anuic3/Poly-Silicon-Resistor-Based-Temperature-Sensor-324/lvs/CB with Chopper/Readme.txt

cb_xschem.spice is the spice file taken from xschem and cb_final_flat.spice is the lvs compatible magic extracted file.
comp.out is the output file from Netgen showing the results.
Clearly the number of devices and the number of netlist are same but it shows the netlists do not match.
