anuic3/Poly-Silicon-Resistor-Based-Temperature-Sensor-324/lvs/Counter/Readme.txt

20bitCounter_fromSchematic.spice is the spice file taken from xschem and 20bitCounter_fromLayout.spice is the lvs compatible magic extracted file.
lvsReport.out is the output file from Netgen showing the results.
Clearly the circuits and netlists match uniquely.
