anuic3/Poly-Silicon-Resistor-Based-Temperature-Sensor-324/lvs/Switched capacitor/read me

"extract1.spice" is the spice file extracted from layout
"untitled-5.spice" is the spice file taken from schematic
LVS is done and its is uniquely matching
