anuic3/Poly-Silicon-Resistor-Based-Temperature-Sensor-324/lvs/Wien Bridge/Readme.txt

Wb_xschem.spice is the spice file taken from xschem and wb_flat.spice is the lvs compatible magic extracted file.
comp.out is the output file from Netgen showing the results.
Clearly the circuits and netlist match.
