anuic3/Poly-Silicon-Resistor-Based-Temperature-Sensor-324/prelayout simulations/Wien Bridge/WIEN BRIDGE PLOTS.pptx

## WIEN BRIDGE PLOTS

## Comparison Table – Resonant Frequency (in kHz)

| -35°C | 27°C | 125°C
tt | 224.91 | 247.742 | 280.5434
ll | 276 | 304.1 | 344.35
hh | 186.21 | 206.445 | 232.27
hl | 237.137 | 261.216 | 295.8
lh | 216.77 | 238.781 | 270.4

## tt - room temp

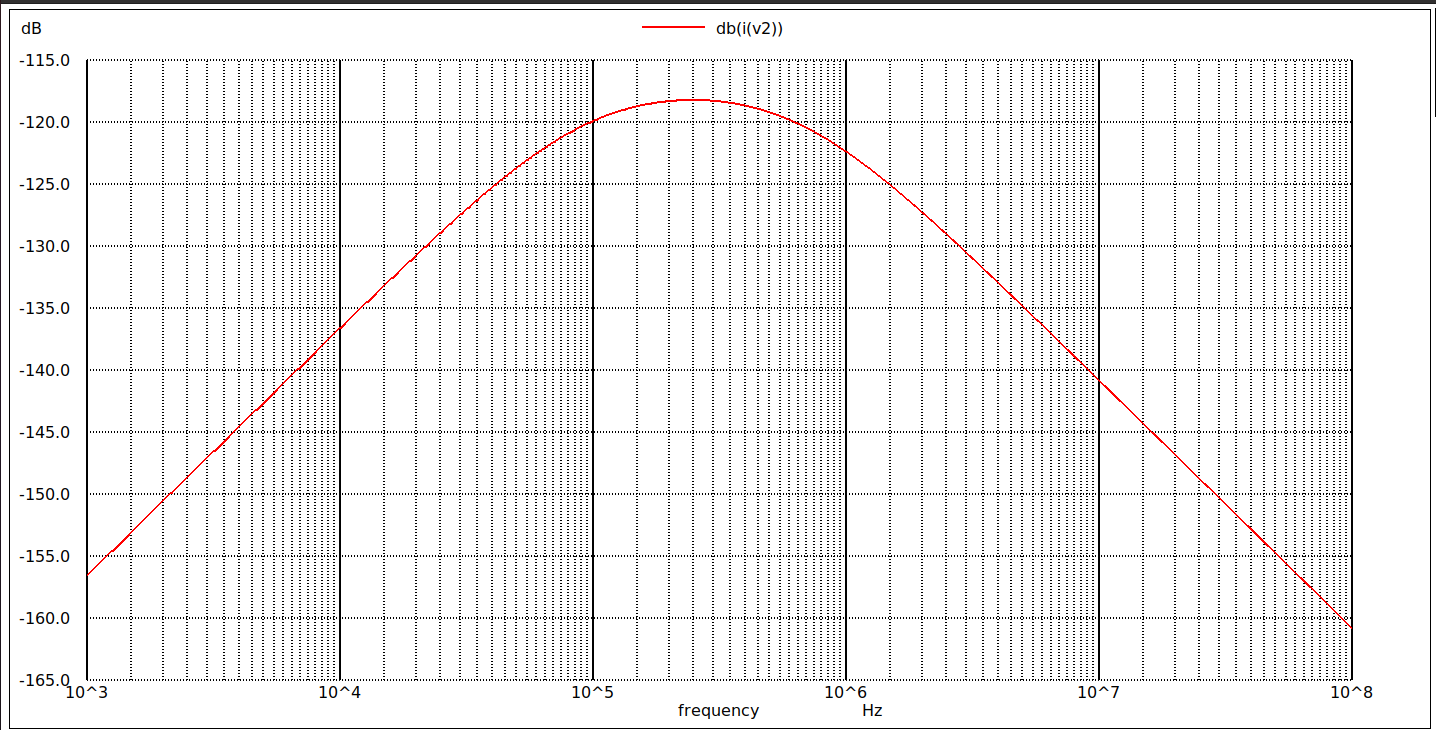
[picture p37: figure]
WBroomtt
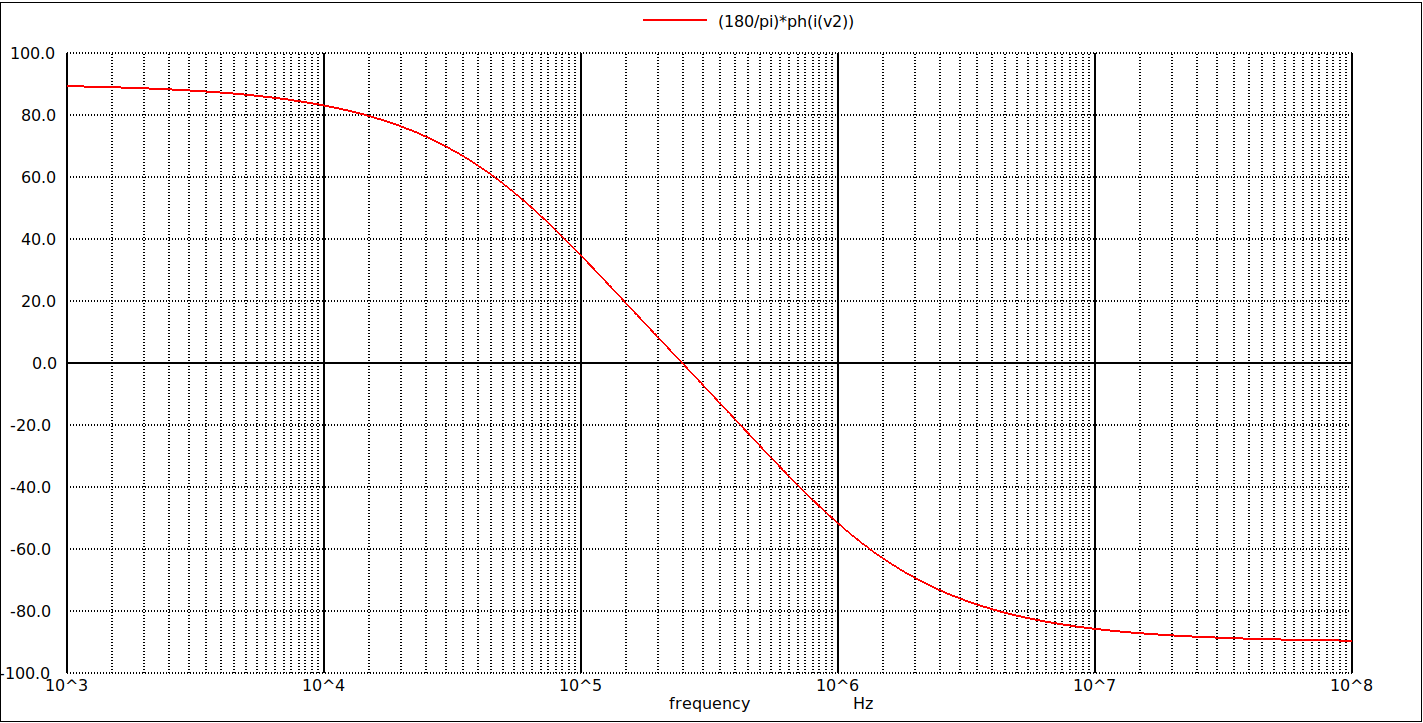
[picture p38: figure]
wbroomttph

## tt - -35degree c

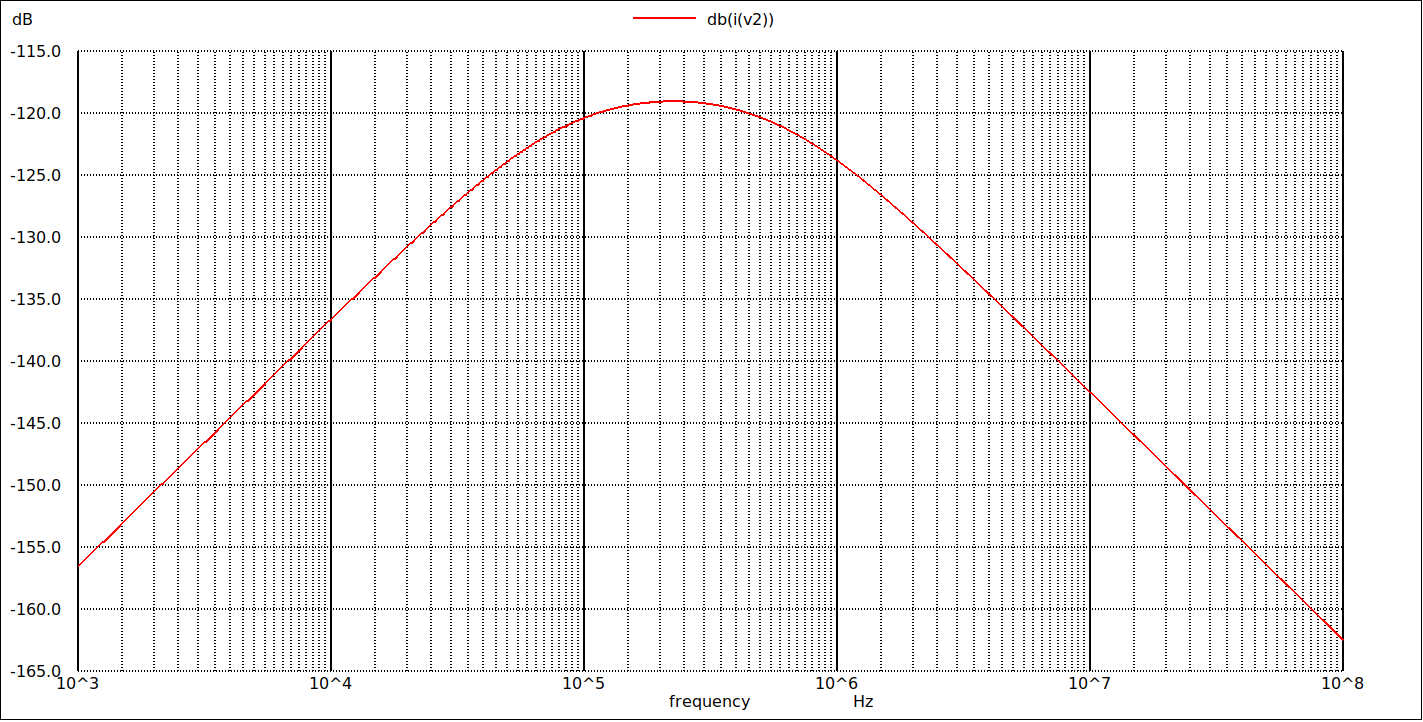
[picture p39: figure]
wb-35ttdb
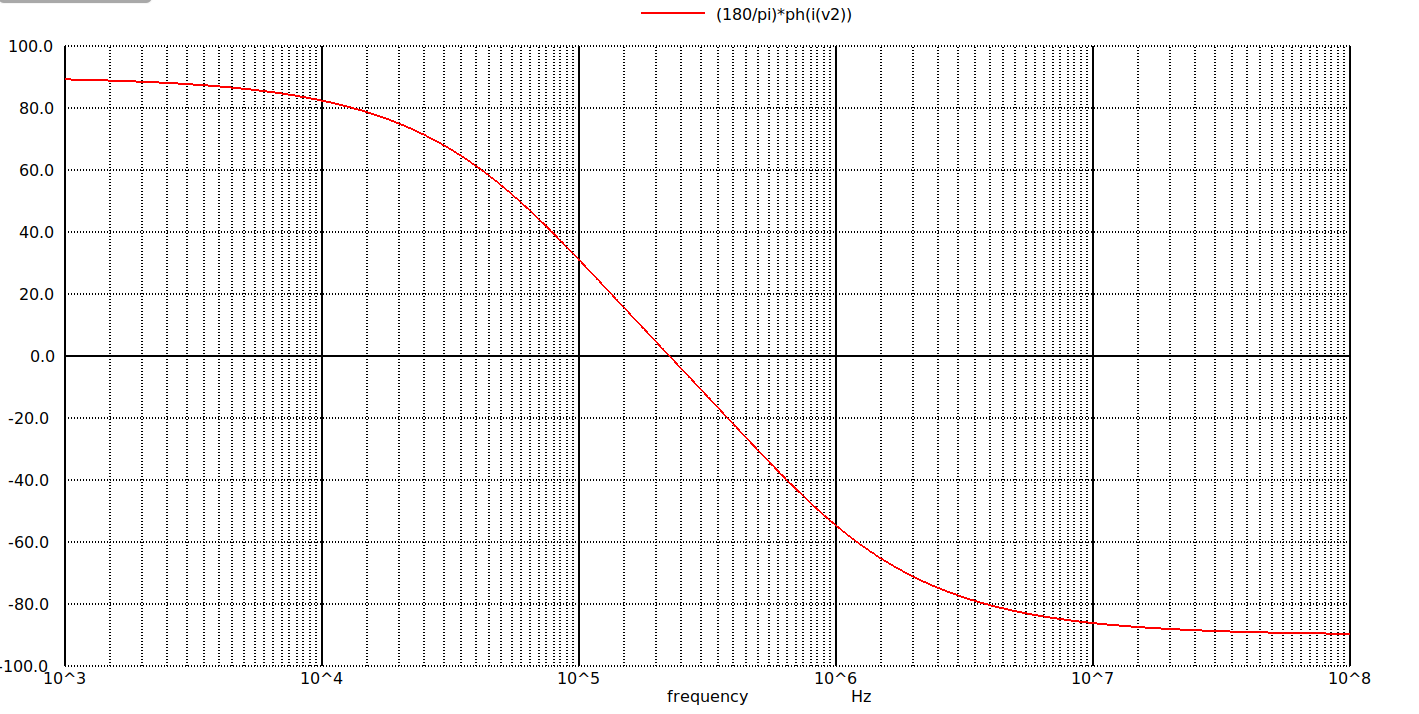
[picture p40: figure]
wb-35ttph

## tt - 125 degree c

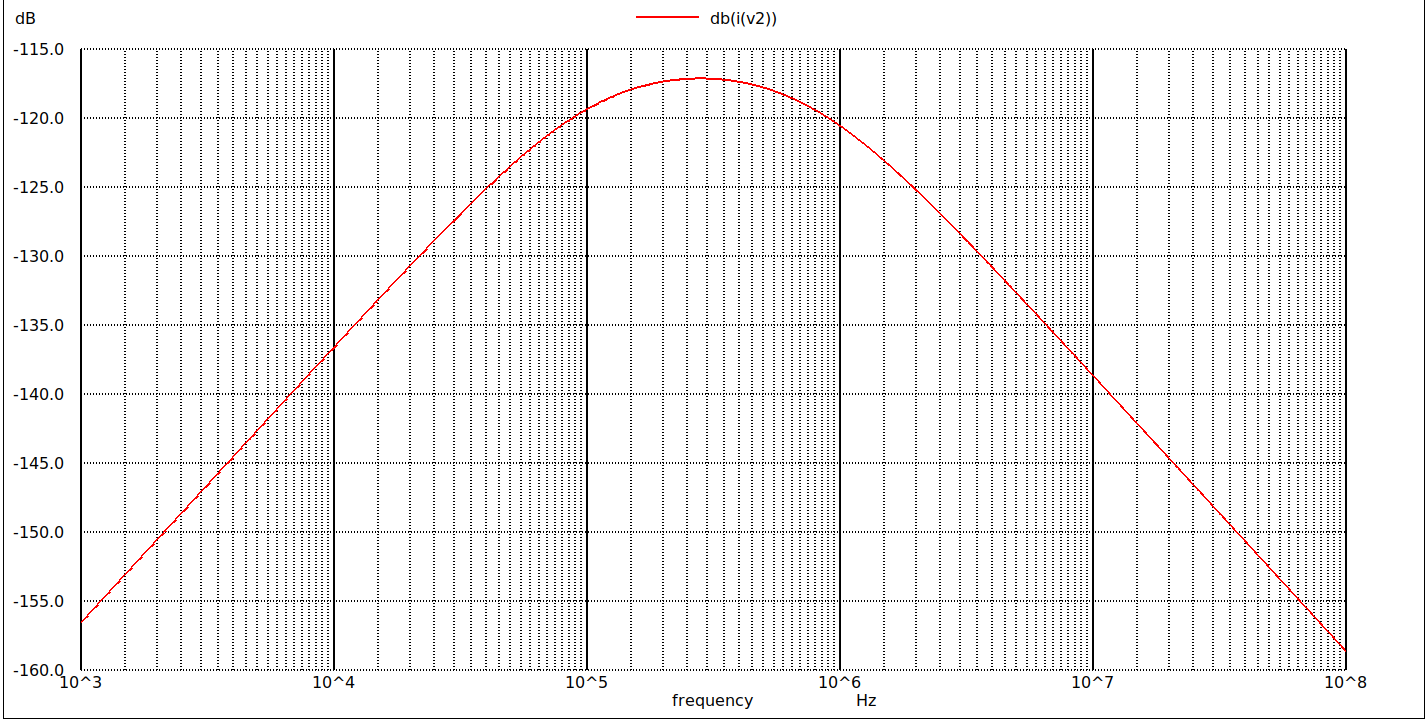
[picture p41: figure]
wb125ttdb
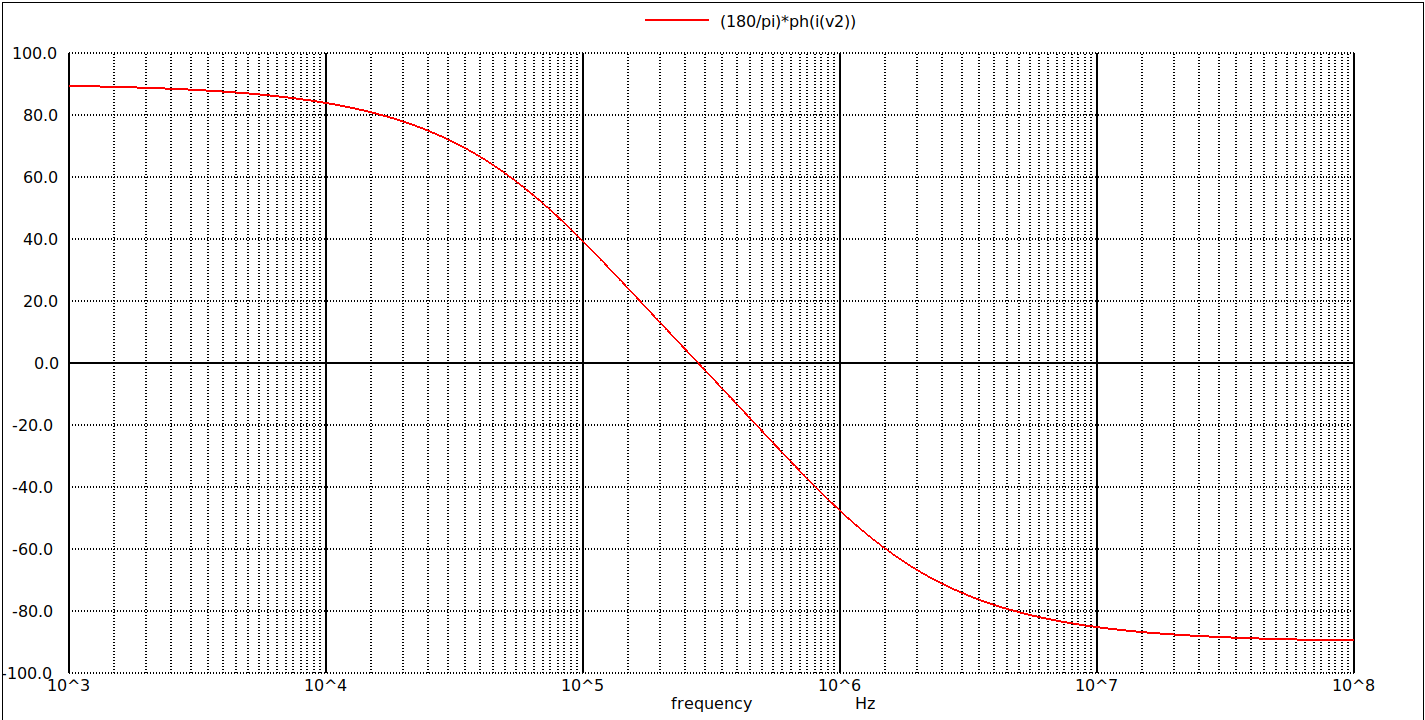
[picture p42: figure]
wb125ttph

## hh -room temp

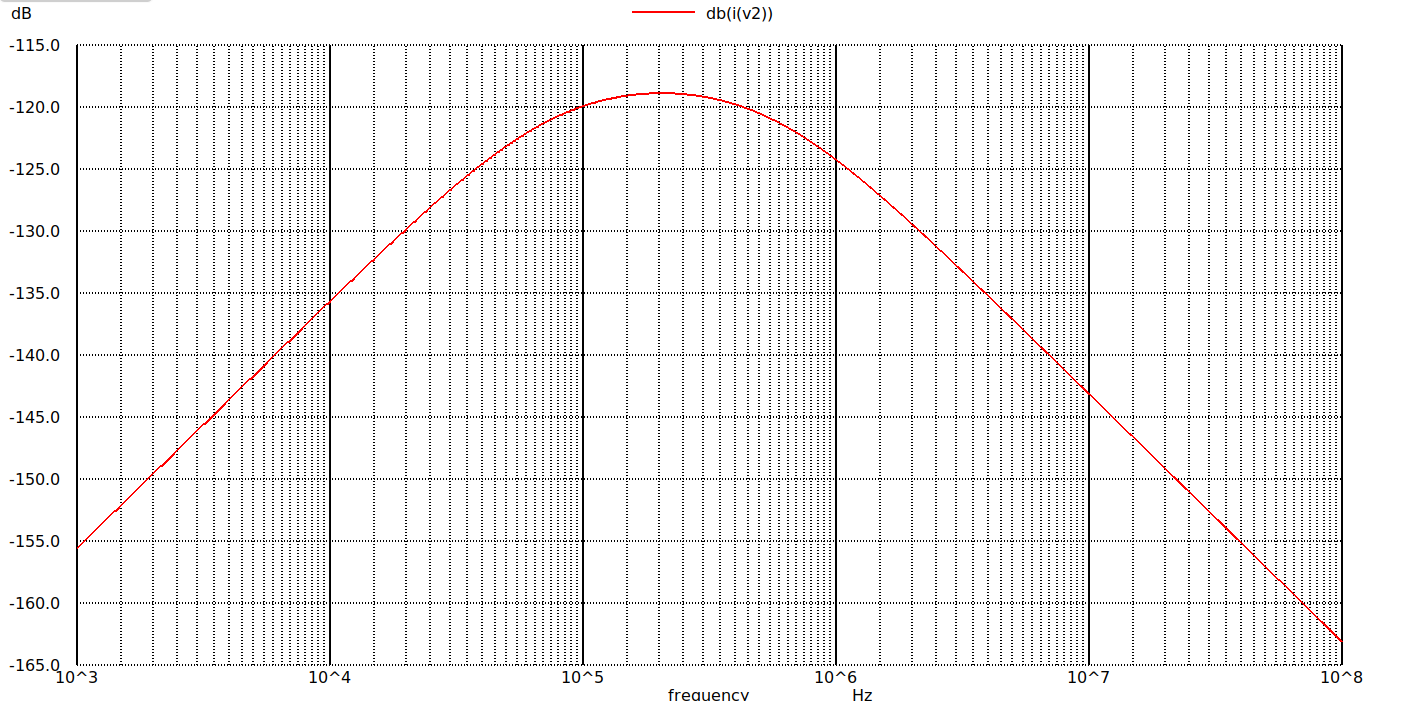
[picture p43: figure]
wbroomhhdb
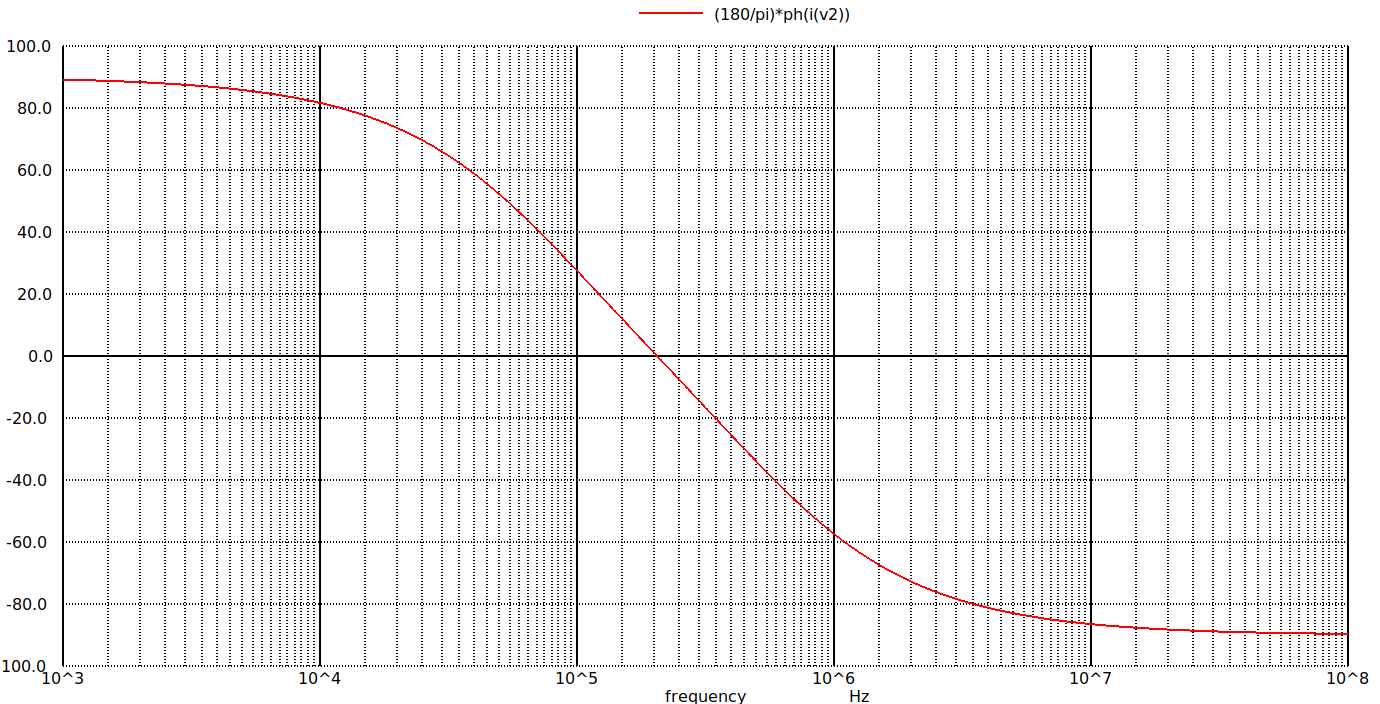
[picture p44: figure]
wbroomhhph

## hh - -35 degree c

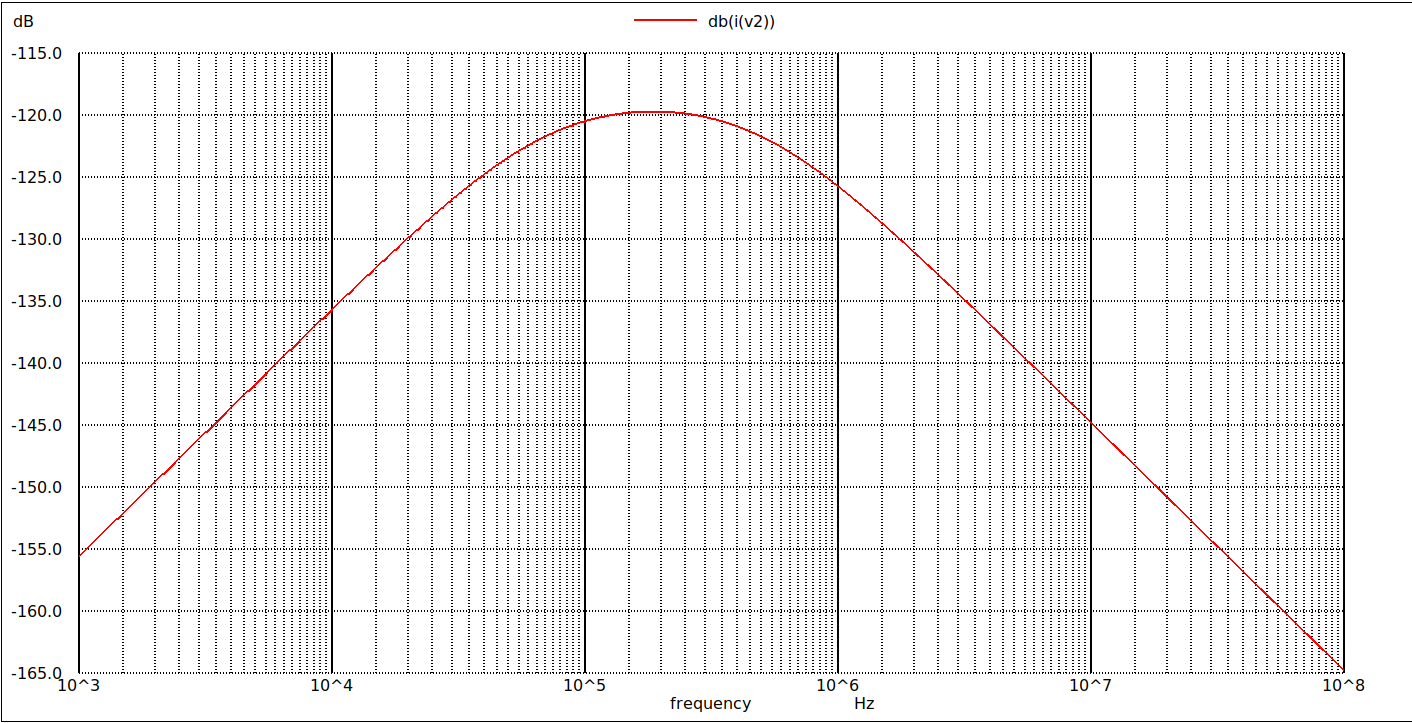
[picture p45: figure]
wb-35hhdb
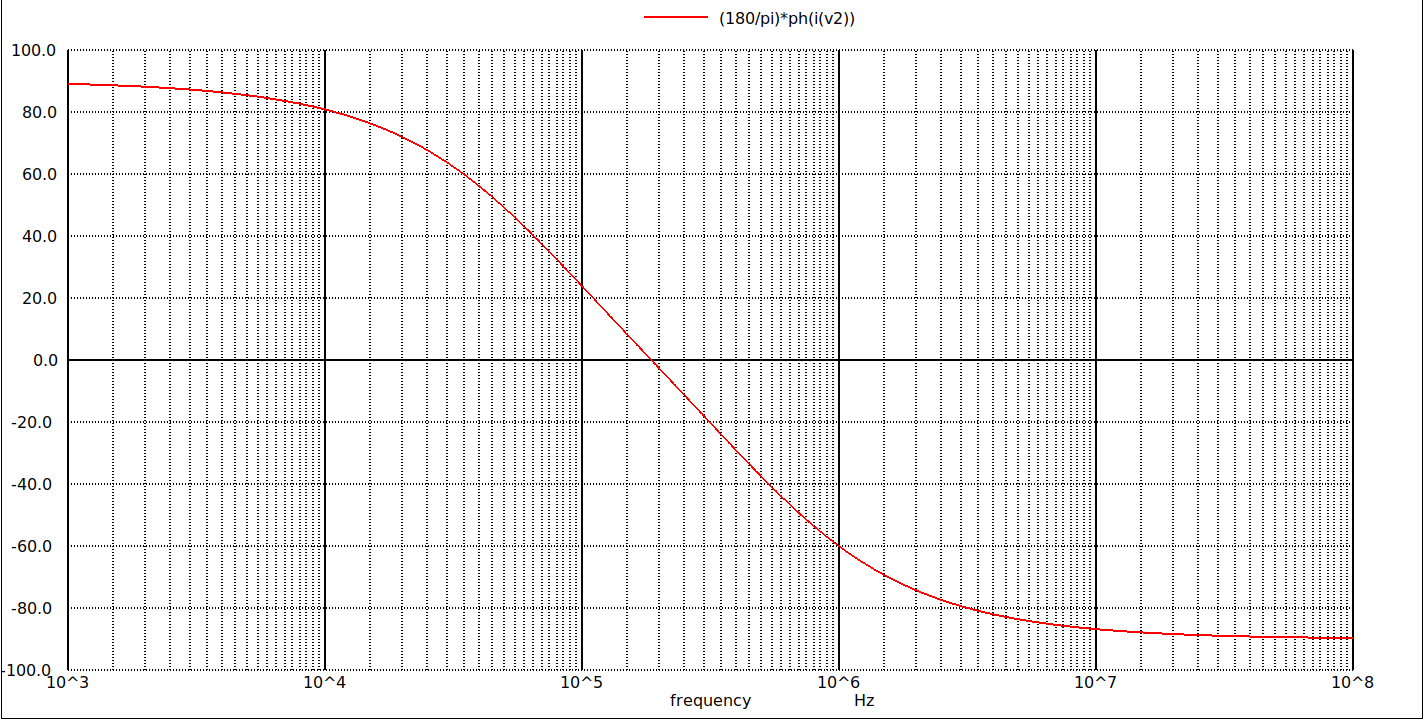
[picture p46: figure]
wb-35hhph

## hh - 125 degree c

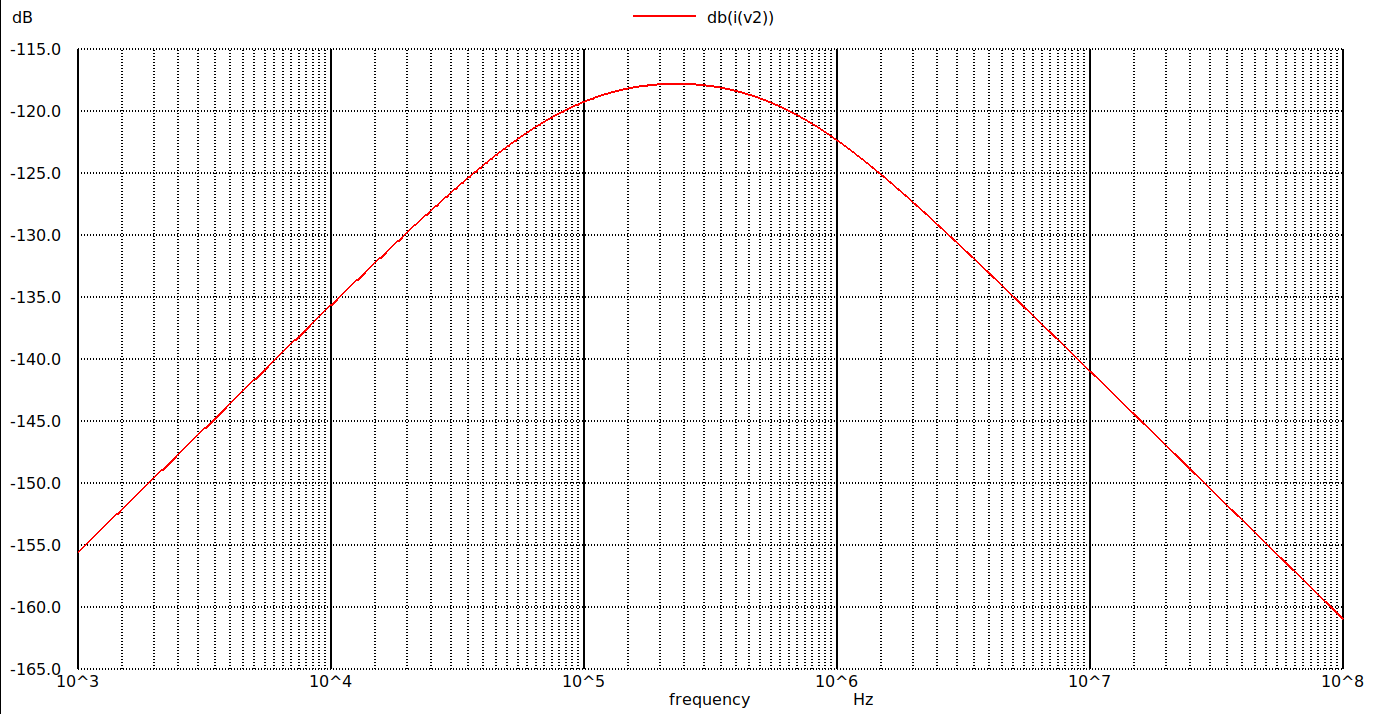
[picture p47: figure]
wb125hhdb
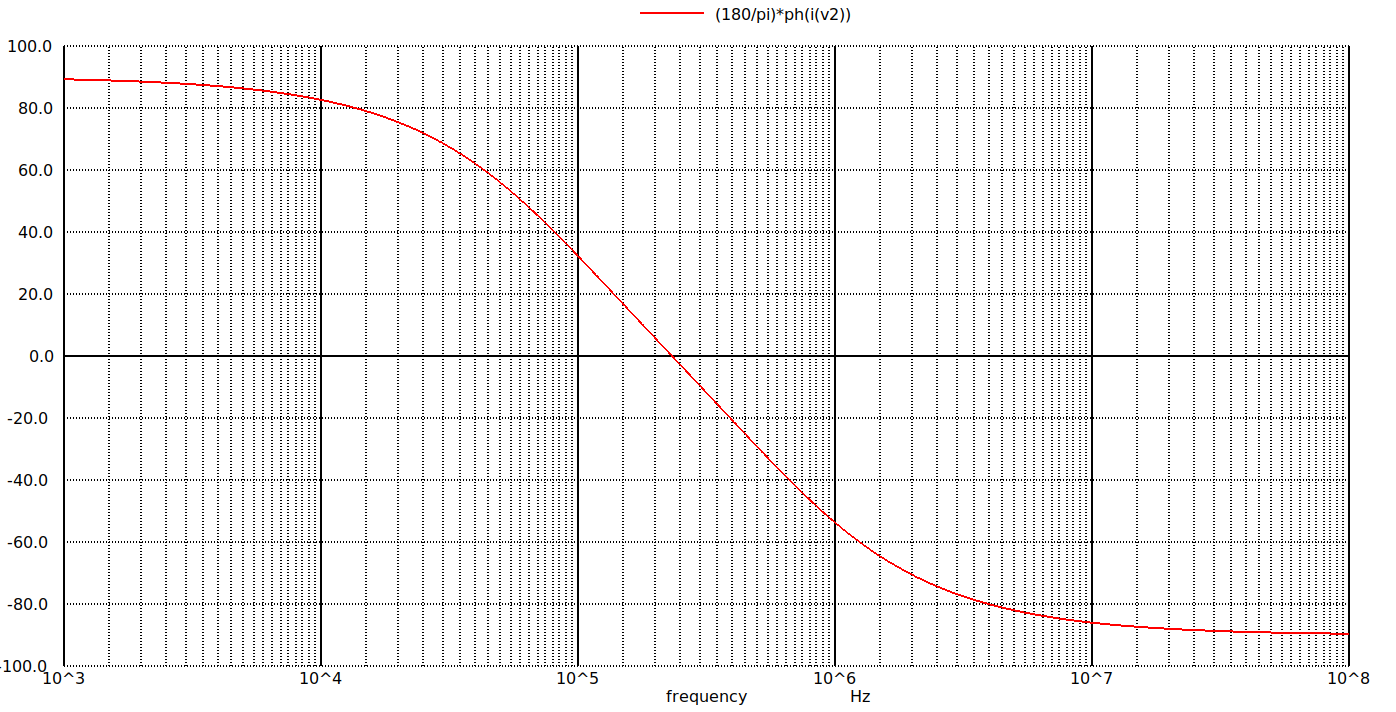
[picture p48: figure]
wb125hhph

## ll - room temp

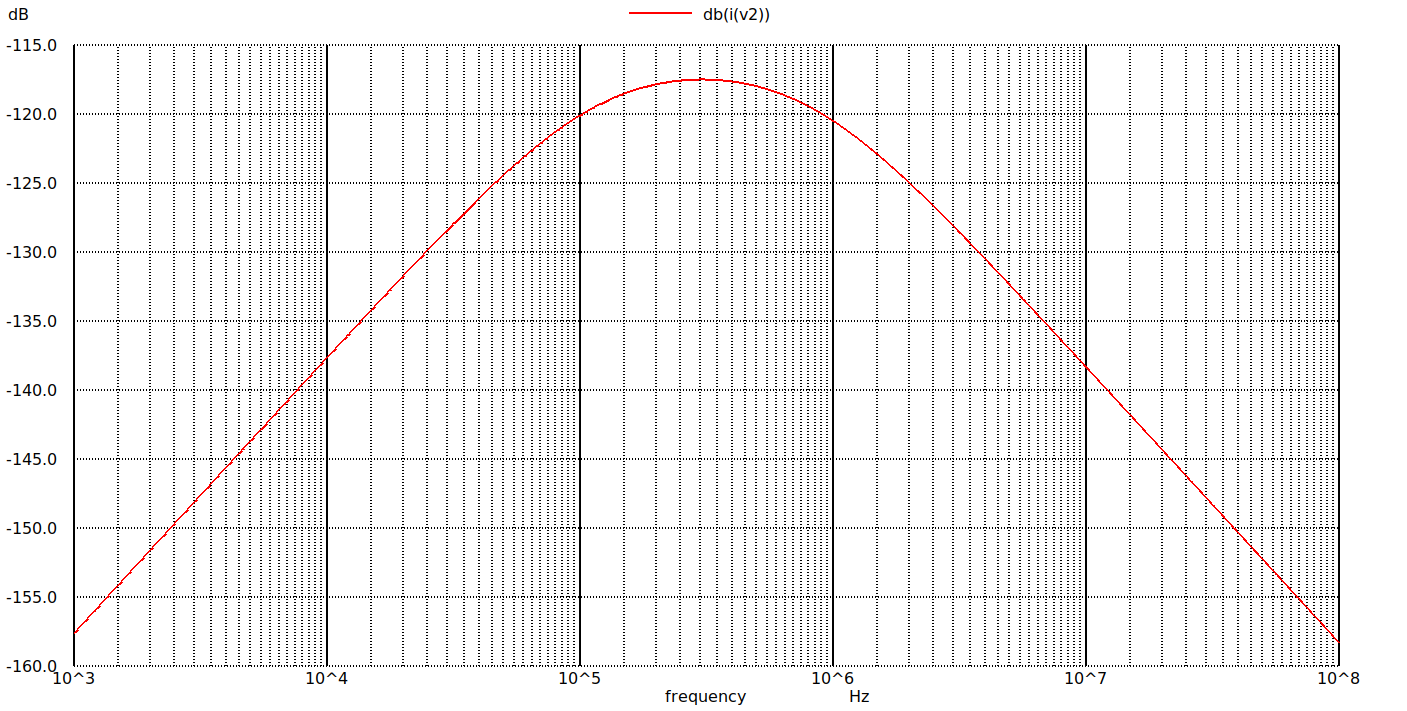
[picture p49: figure]
wbroomlldb
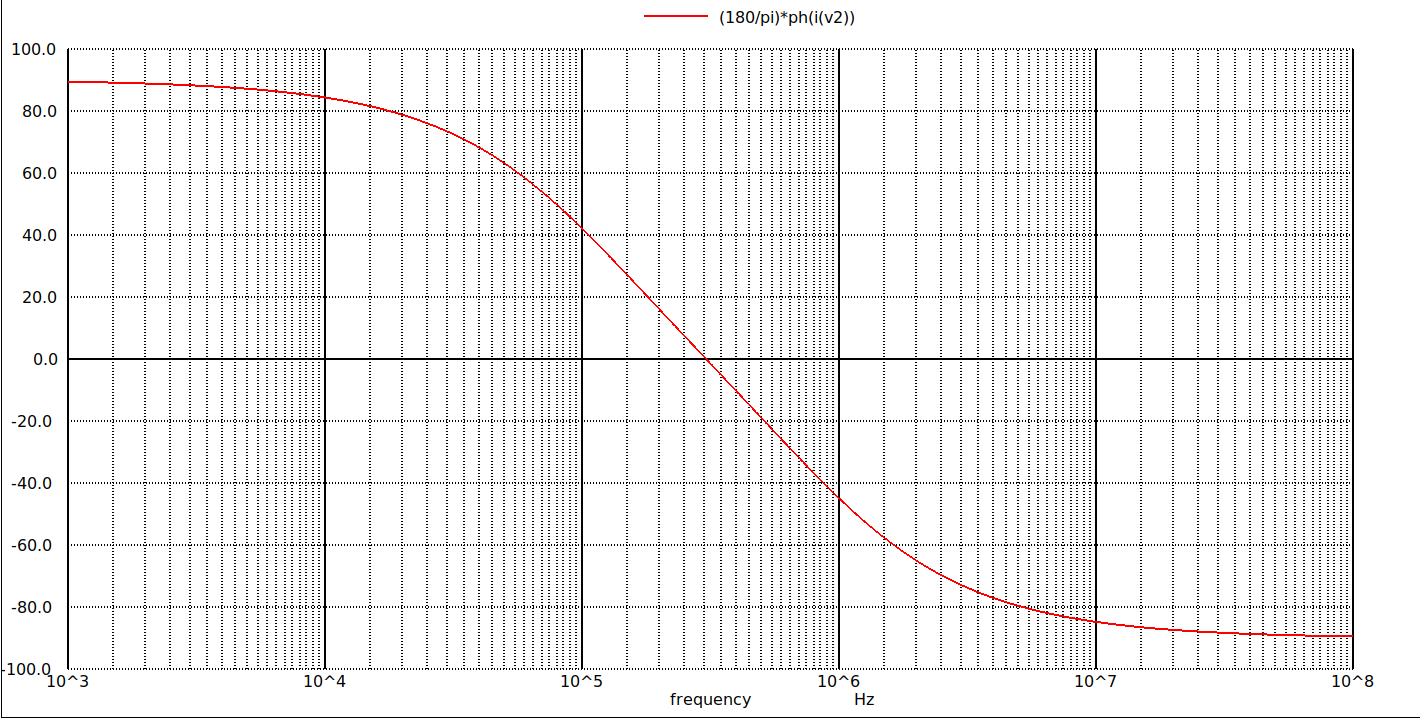
[picture p50: figure]
wbroomllph

## ll - -35degree c

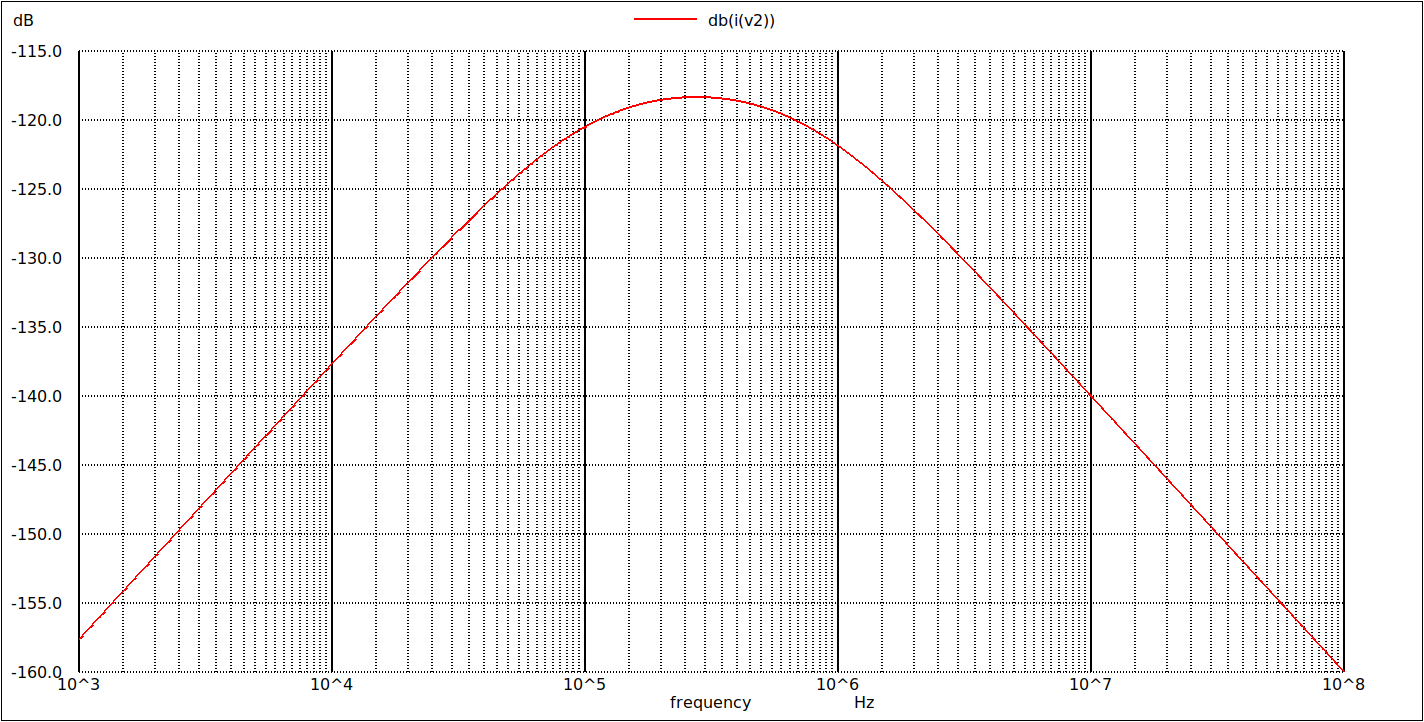
[picture p51: figure]
wb-35lldb
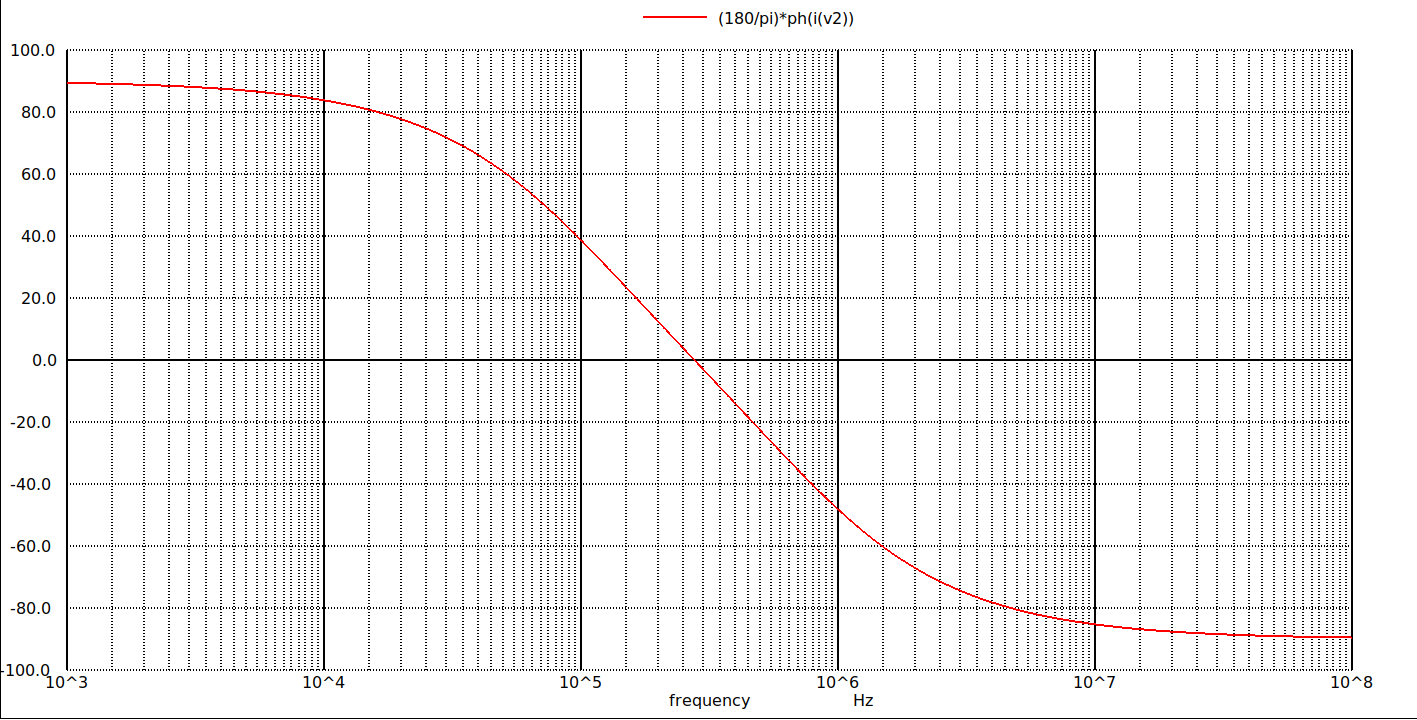
[picture p52: figure]
wb-35llph

## ll - 125 degree c

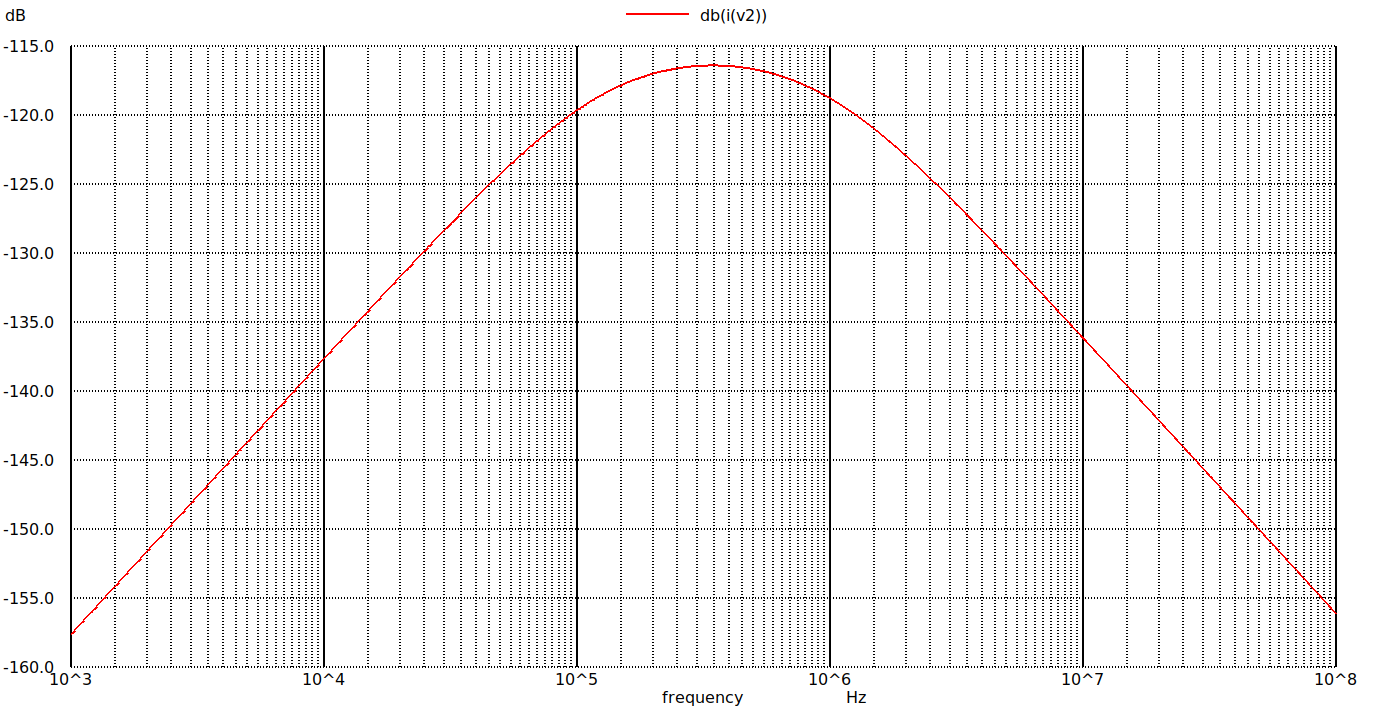
[picture p53: figure]
wb125lldb
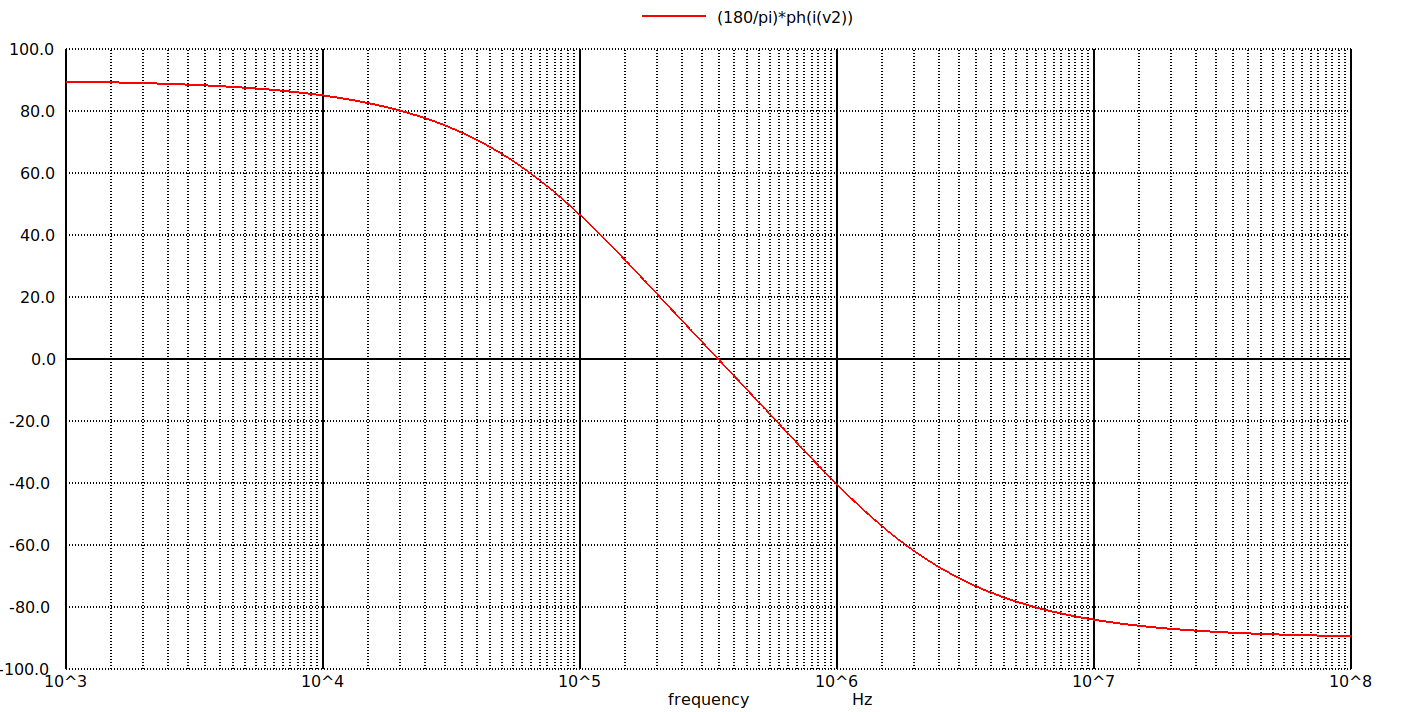
[picture p54: figure]
wb125llph

## hl - room temp

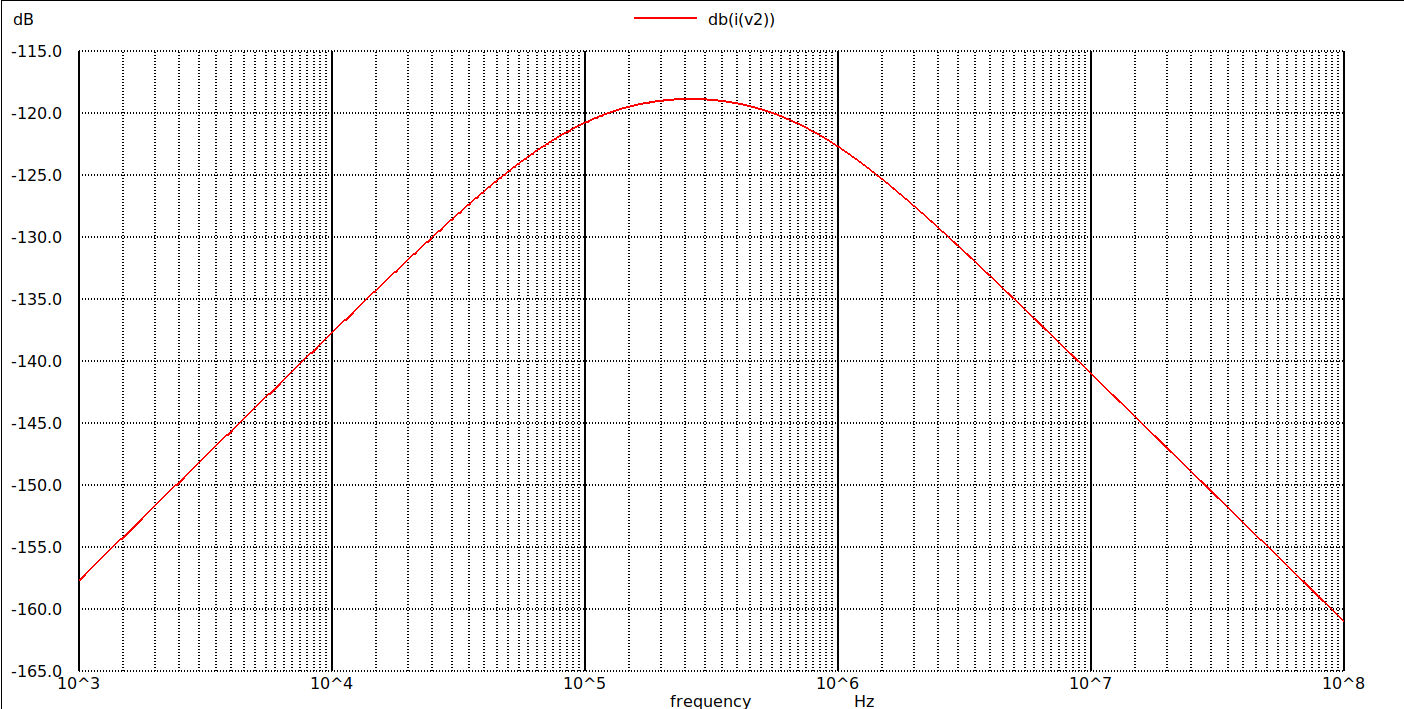
[picture p55: figure]
wbroomhldb
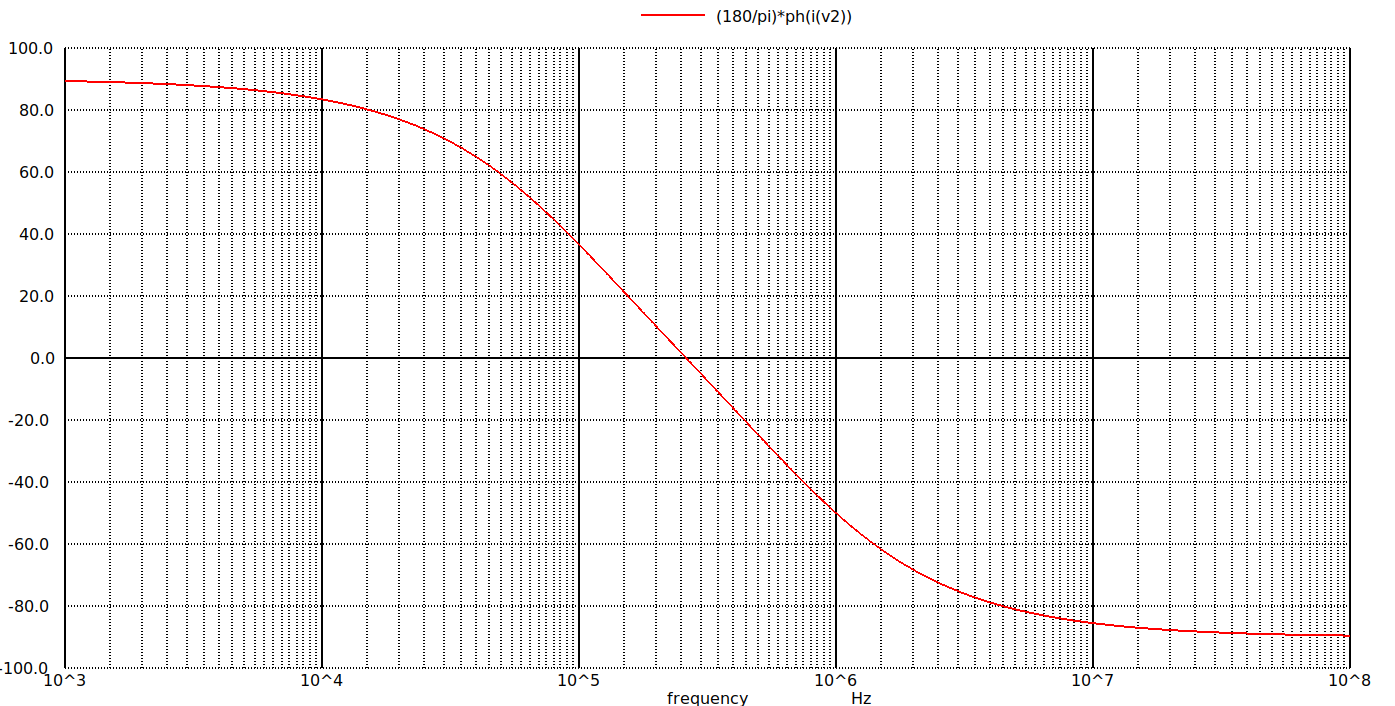
[picture p56: figure]
wbroomhlph

## hl - -35 degree c

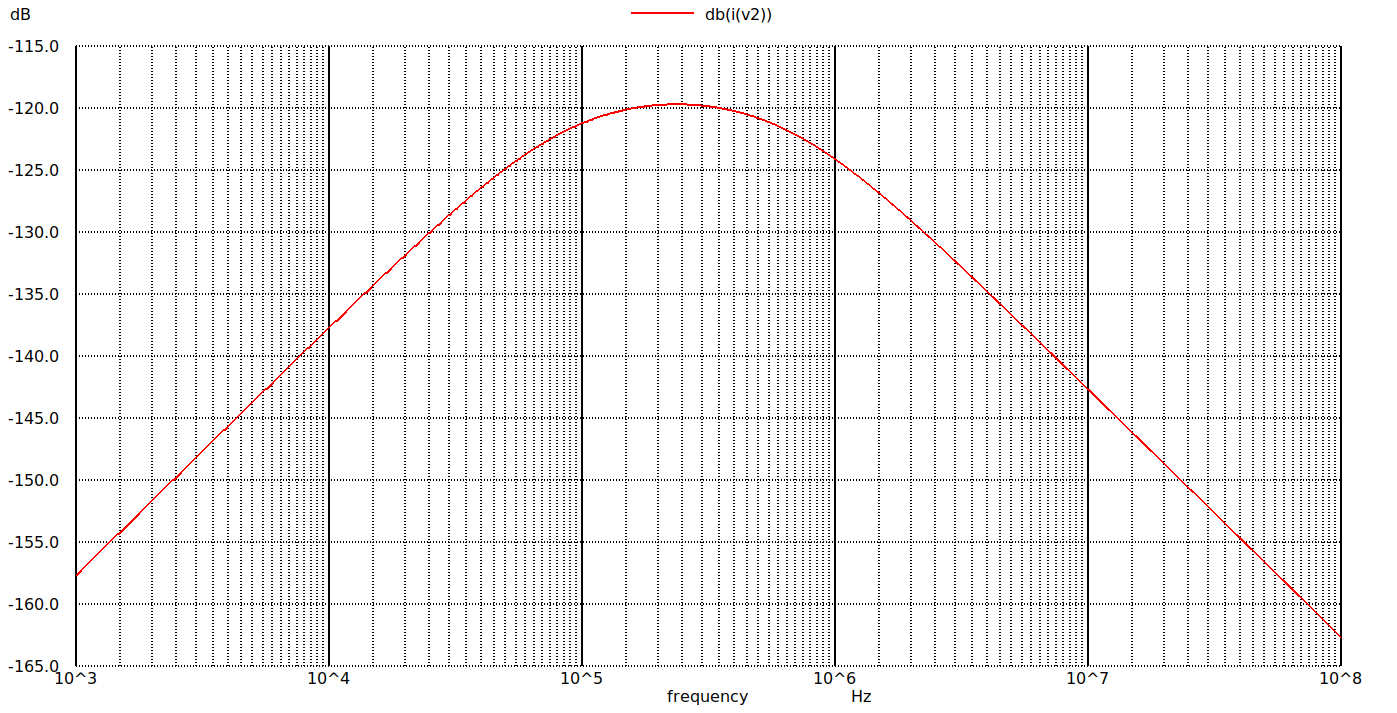
[picture p57: figure]
wb-35hldb
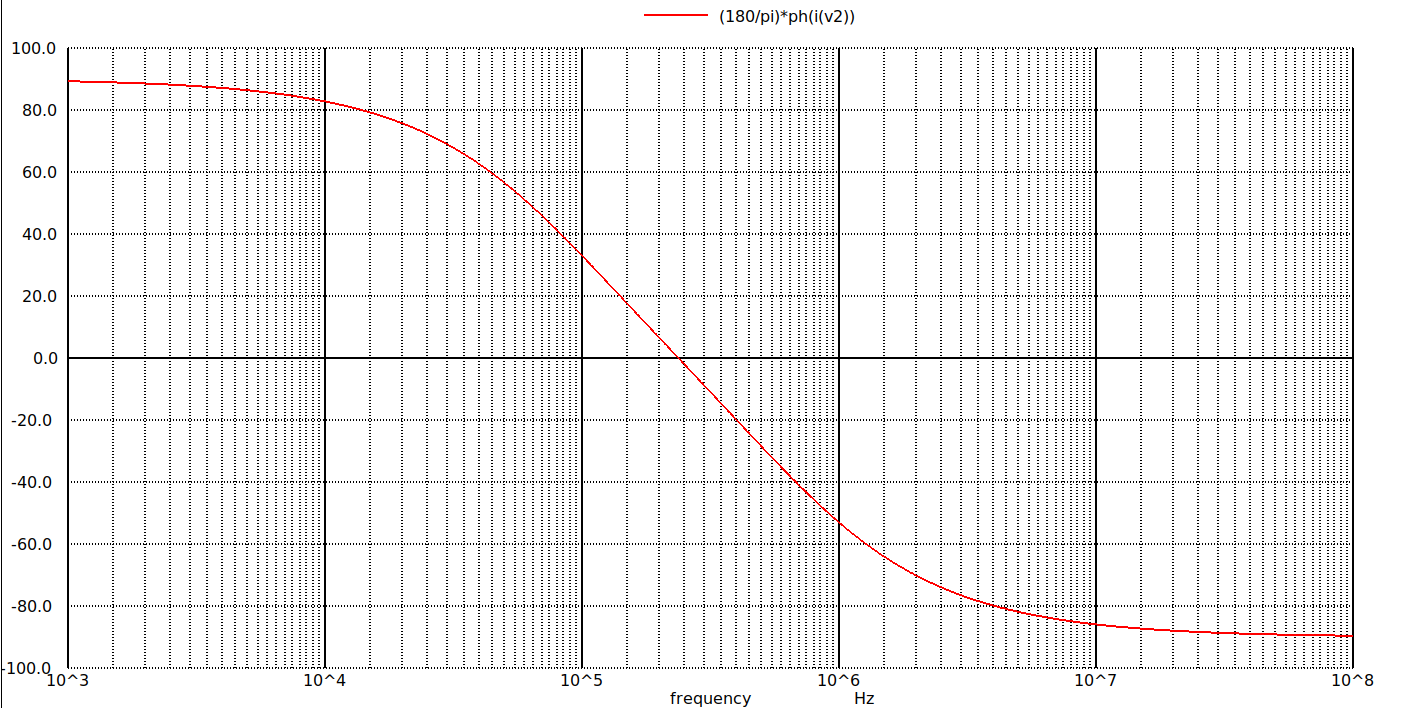
[picture p58: figure]
wb-35hlph

## hl - 125 degree c

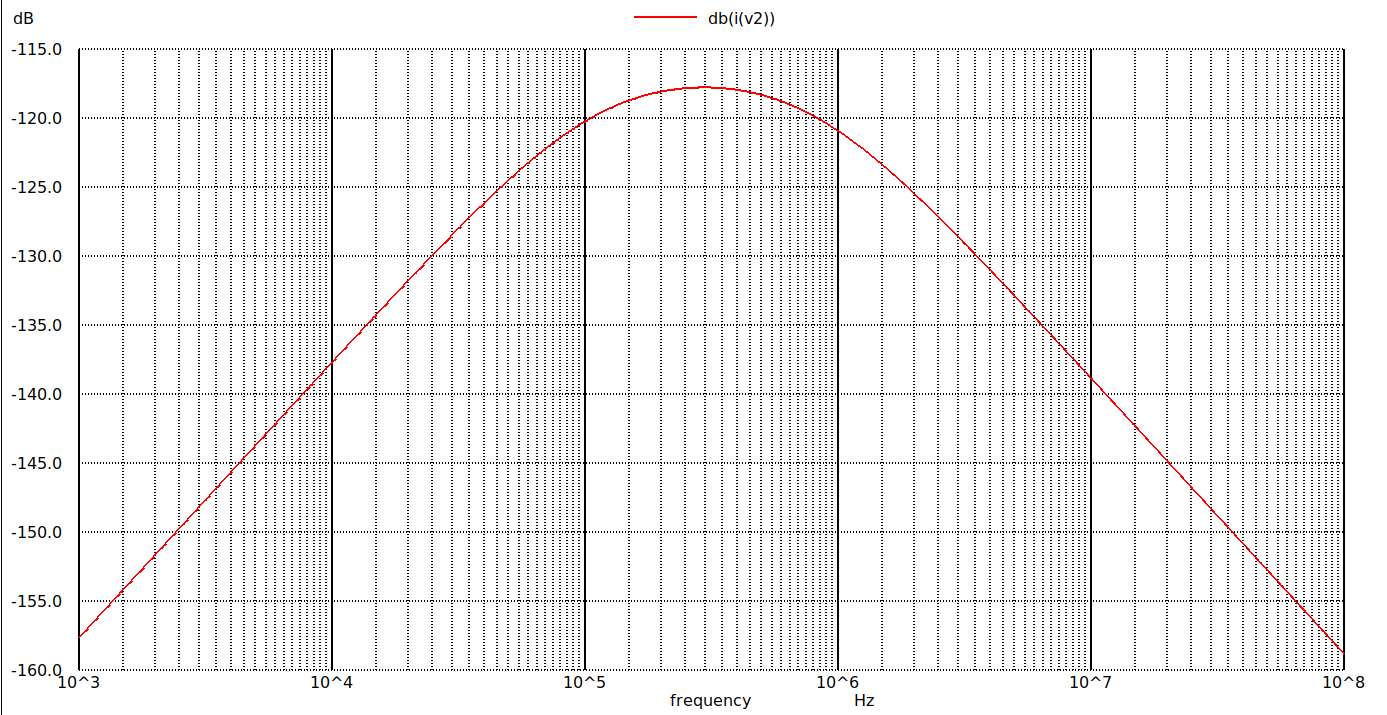
[picture p59: figure]
wb125hldb
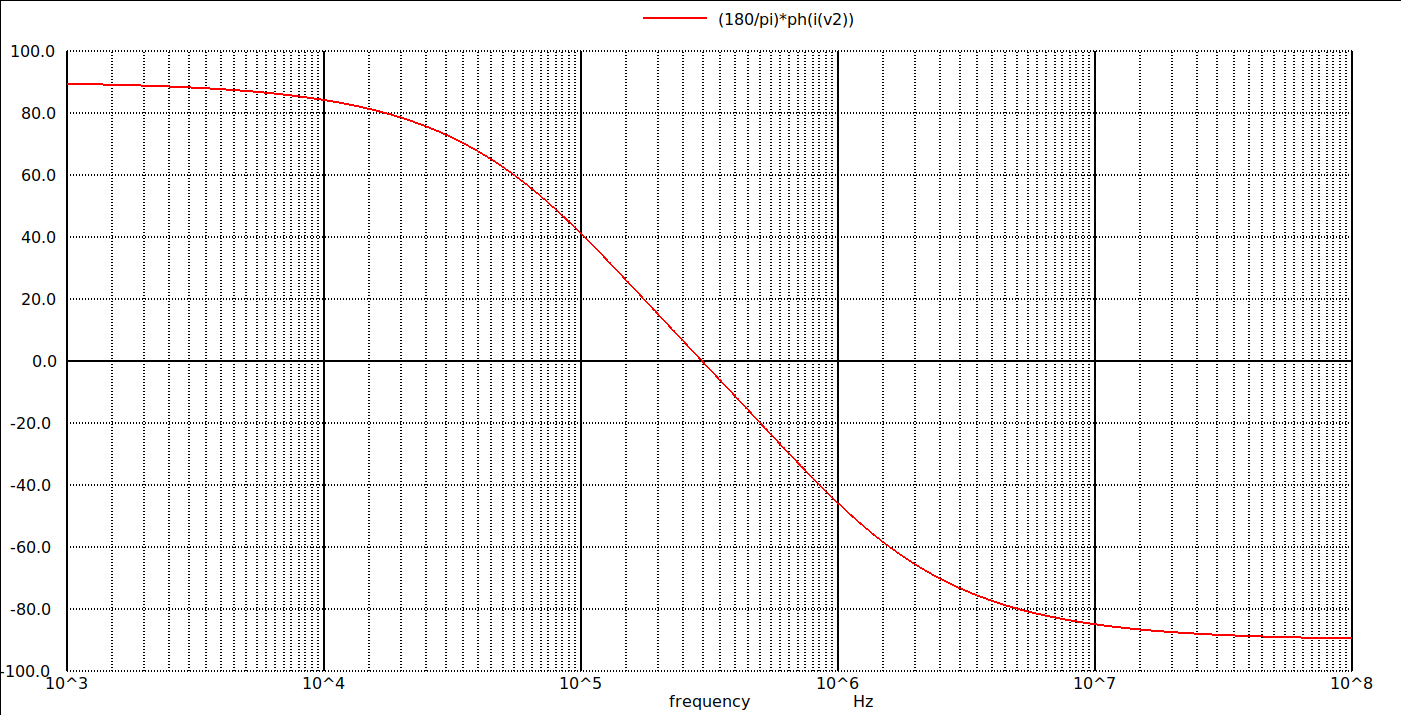
[picture p60: figure]
wb125hlph

## lh - room temp

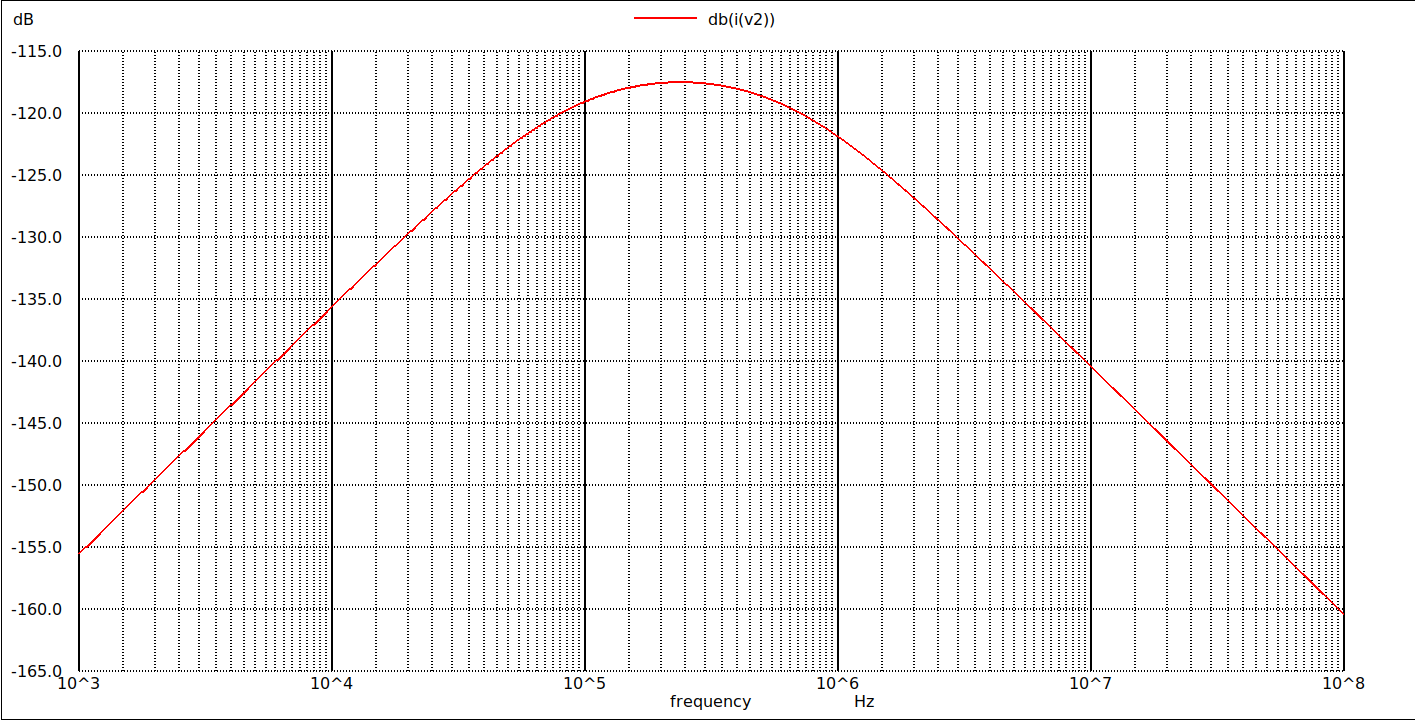
[picture p61: figure]
wbroomlhdb
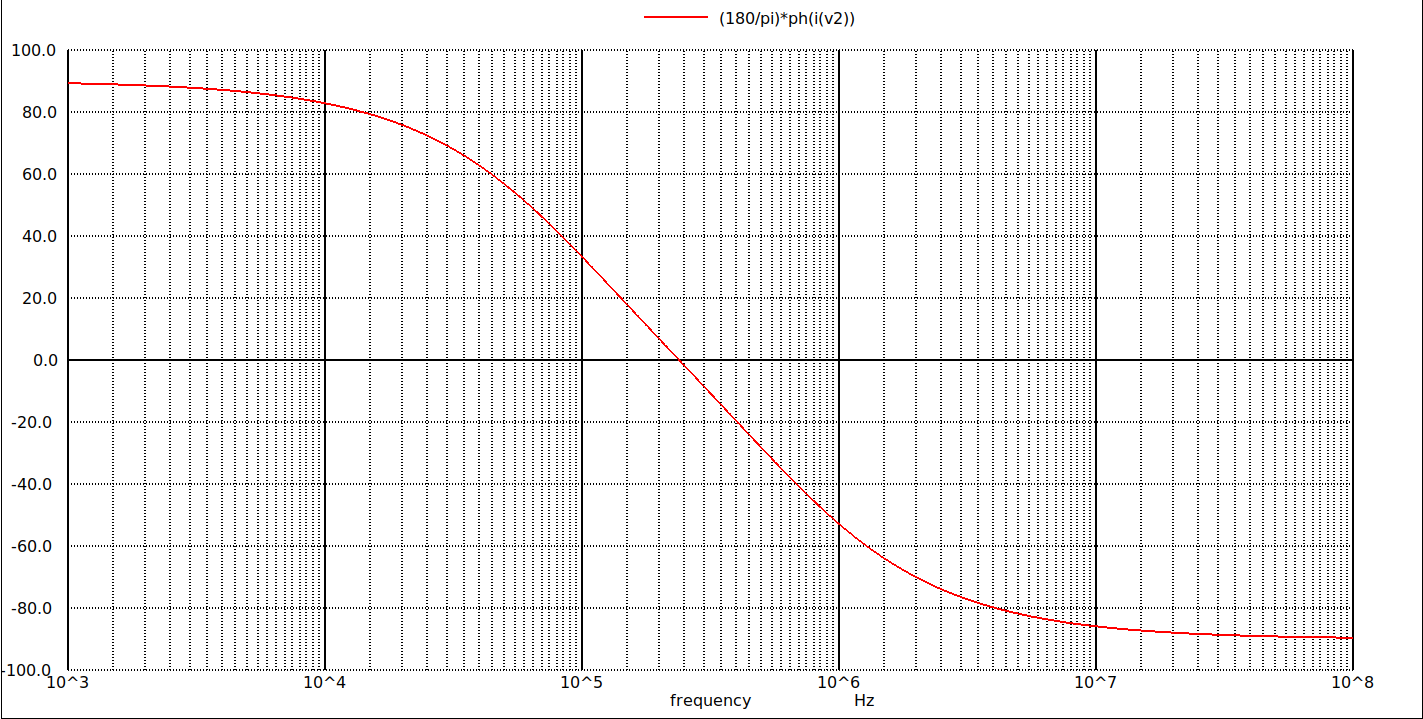
[picture p62: figure]
wbroomlhph

## lh - -35 degree c

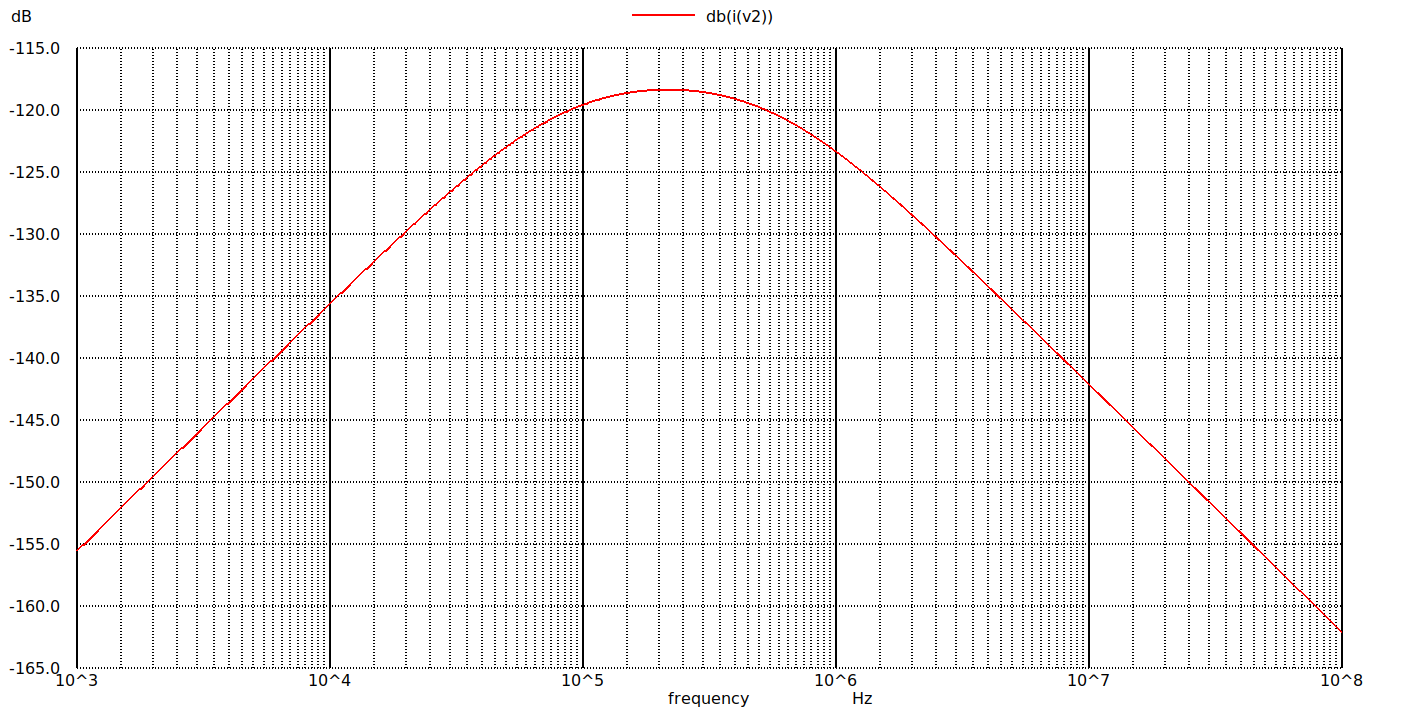
[picture p63: figure]
wb-35lhdb
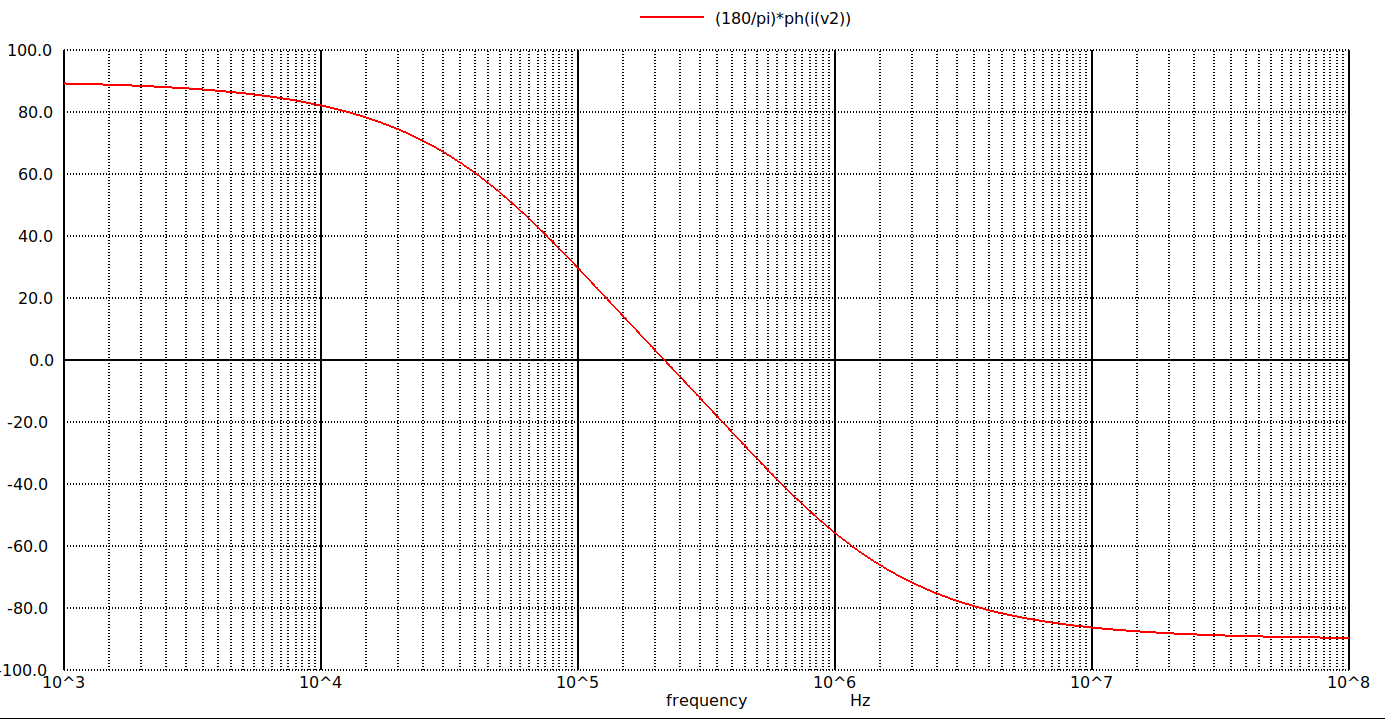
[picture p64: figure]
wb-35lhph

## lh - 125 degree c

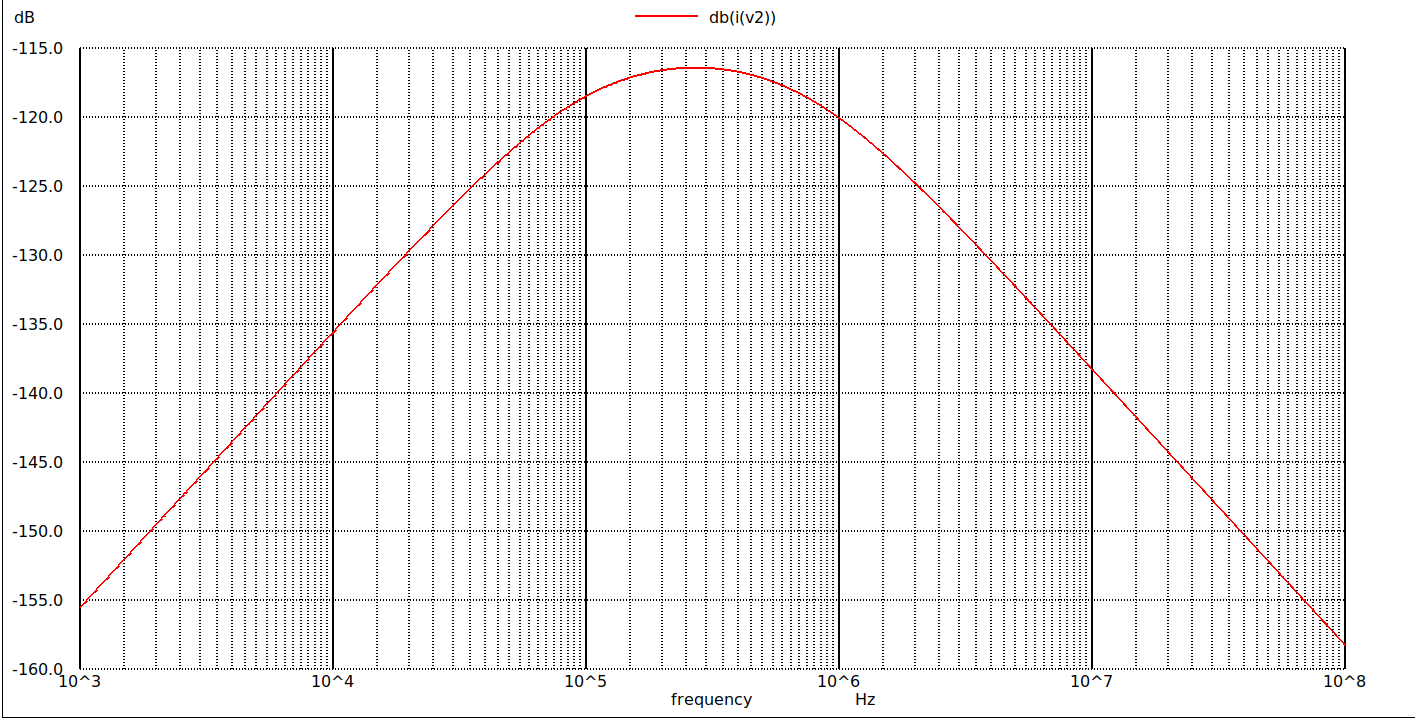
[picture p65: figure]
wb125lhdb
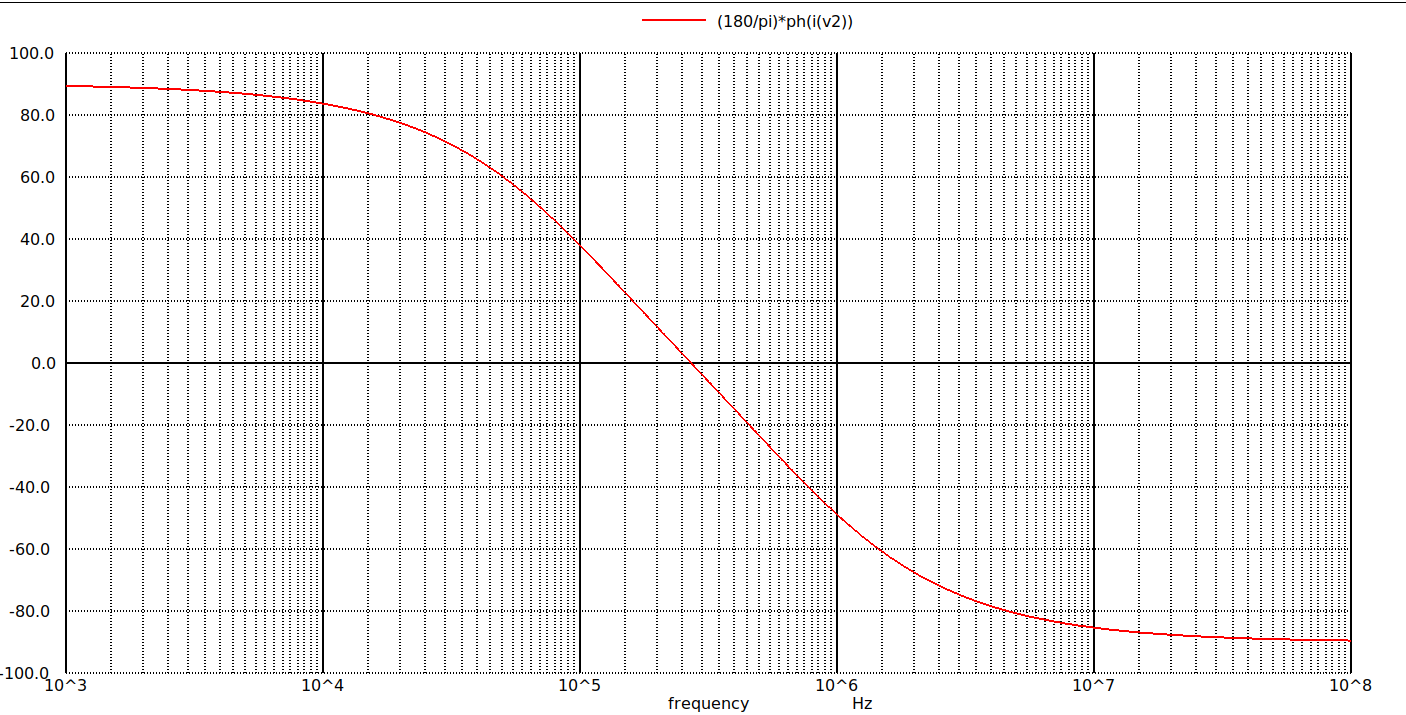
[picture p66: figure]
wb125lhph
