anuic3/Poly-Silicon-Resistor-Based-Temperature-Sensor-324/postlayout simulations/Edge Combiner/edgepostlay.jpg

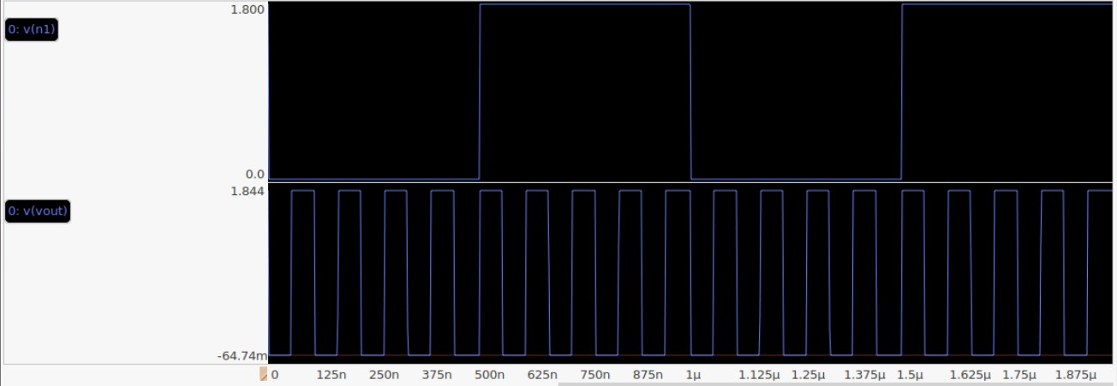
postlayout simulations/Edge Combiner/edgepostlay.jpg
