anuic3/Poly-Silicon-Resistor-Based-Temperature-Sensor-324/postlayout simulations/Switched capacitor/postlayout sim 1.PNG

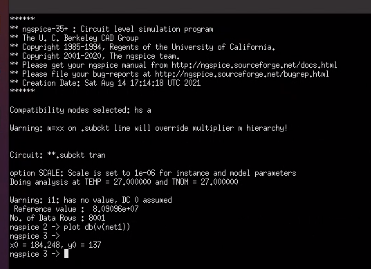
postlayout simulations/Switched capacitor/postlayout sim 1.PNG
