anuic3/Poly-Silicon-Resistor-Based-Temperature-Sensor-324/prelayout simulations/Cb and chopper/Screenshot from 2021-08-22 22-53-10.png

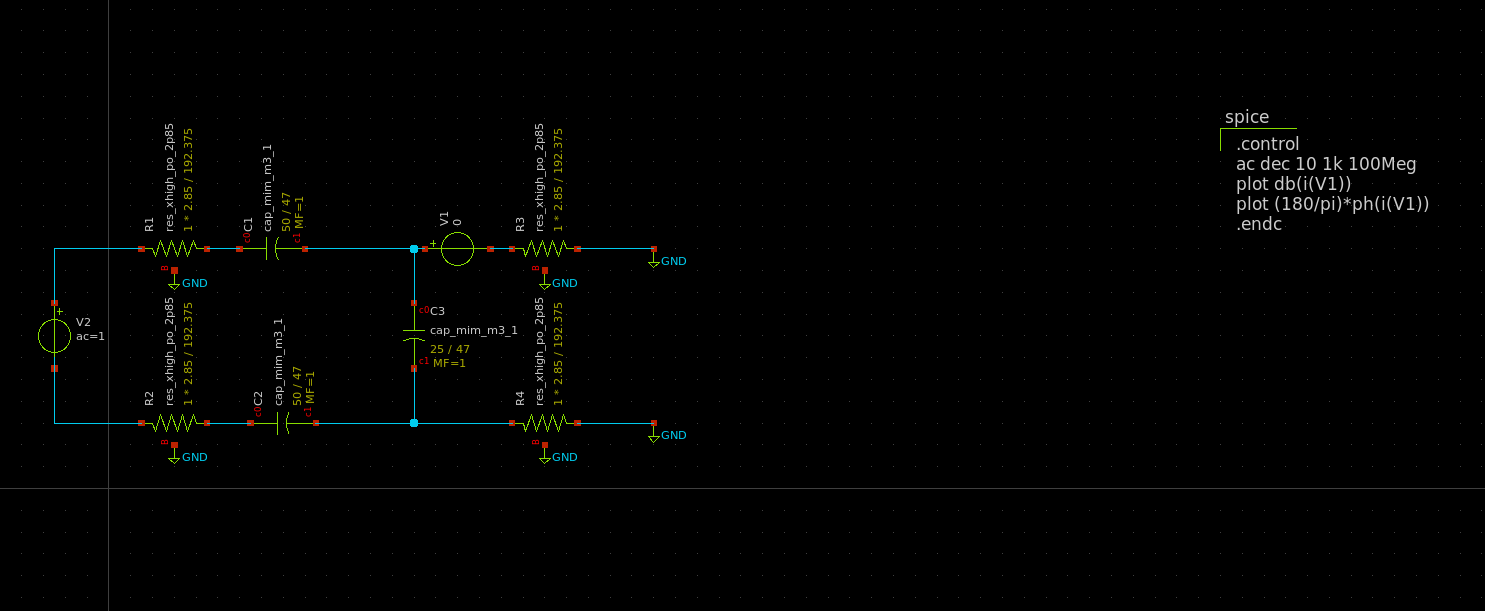
prelayout simulations/Cb and chopper/Screenshot from 2021-08-22 22-53-10.png
