anuic3/Poly-Silicon-Resistor-Based-Temperature-Sensor-324/prelayout simulations/edge/edgesch.jpg

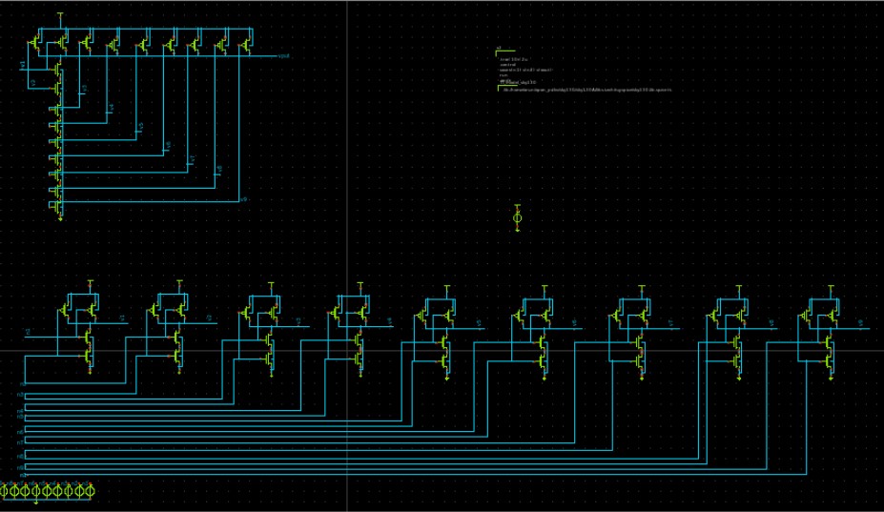
prelayout simulations/edge/edgesch.jpg
