anuic3/Poly-Silicon-Resistor-Based-Temperature-Sensor-324/prelayout simulations/Switched capacitor/prelayout sim.PNG

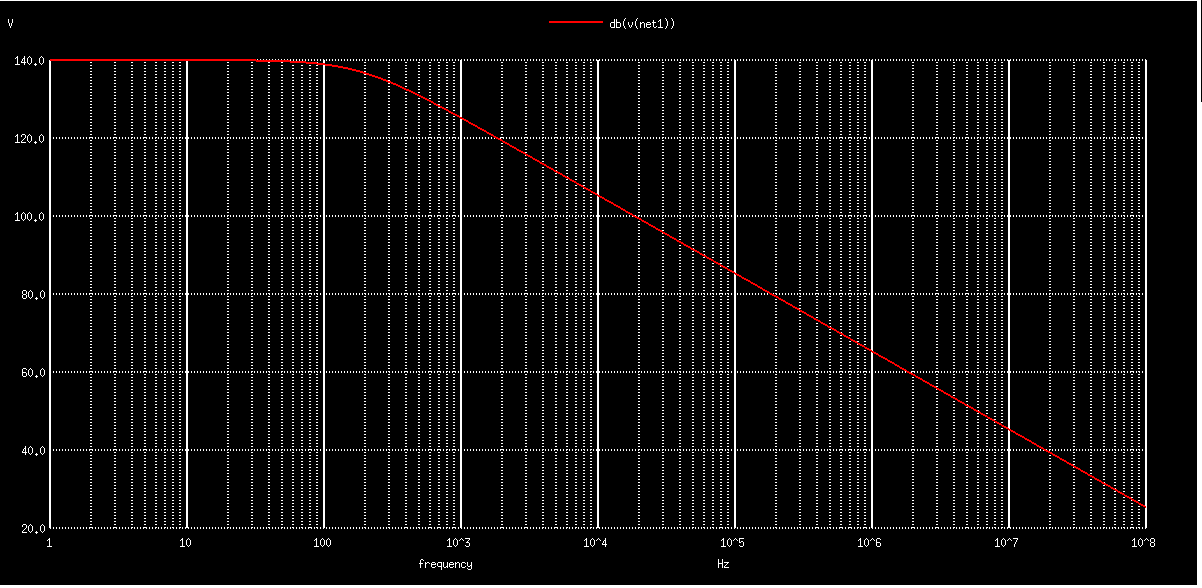
prelayout simulations/Switched capacitor/prelayout sim.PNG
