anuic3/Poly-Silicon-Resistor-Based-Temperature-Sensor-324/postlayout simulations/Counter/20bitCounter_testbench.spice

* SPICE3 file created from 20bitCounter.ext - technology: sky130A
V1 VDD GND 1.8
V2 Vclk GND pulse(0V 1.8V clk_offset clk_risetime clk_falltime {clk_period/2} clk_period 0deg) 
V4 Vreset GND pwl(0.0us 1.8V, 0.090us 1.8V, 0.091us 0.0V, 0.100us 0.0V, 0.101us 1.8V)

.param clk_period=1us clk_offset={clk_period/2} clk_risetime=5ns clk_falltime={clk_risetime}
.func data_time(x) {clk_offset/2 + x*(clk_period/2)}

.tran 1us {32*clk_period}
.save Vclk Vreset 
.save sky130_fd_sc_hd__dfrbp_1_0[0]/Q sky130_fd_sc_hd__dfrbp_1_0[1]/Q sky130_fd_sc_hd__dfrbp_1_0[2]/Q sky130_fd_sc_hd__dfrbp_1_0[3]/Q
.save sky130_fd_sc_hd__dfrbp_1_0[4]/Q sky130_fd_sc_hd__dfrbp_1_0[5]/Q sky130_fd_sc_hd__dfrbp_1_0[6]/Q sky130_fd_sc_hd__dfrbp_1_0[7]/Q
.save sky130_fd_sc_hd__dfrbp_1_0[8]/Q sky130_fd_sc_hd__dfrbp_1_0[9]/Q sky130_fd_sc_hd__dfrbp_1_0[10]/Q sky130_fd_sc_hd__dfrbp_1_0[11]/Q
.save sky130_fd_sc_hd__dfrbp_1_0[12]/Q sky130_fd_sc_hd__dfrbp_1_0[13]/Q sky130_fd_sc_hd__dfrbp_1_0[14]/Q sky130_fd_sc_hd__dfrbp_1_[15]/Q
.save sky130_fd_sc_hd__dfrbp_1_0[16]/Q sky130_fd_sc_hd__dfrbp_1_0[17]/Q sky130_fd_sc_hd__dfrbp_1_0[18]/Q sky130_fd_sc_hd__dfrbp_1_0[19]/Q
.lib ~/open_pdks/sky130/sky130A/libs.tech/ngspice/sky130.lib.spice tt

.subckt sky130_fd_sc_hd__dfrbp_1 CLK D Q Q_N RESET_B VNB VPB
X0 a_805_47# a_761_289# a_639_47# VNB sky130_fd_pr__nfet_01v8 ad=0p pd=0u as=0p ps=0u w=420000u l=150000u
X1 VPB a_1283_21# a_1847_47# VPB sky130_fd_pr__pfet_01v8_hvt ad=0p pd=0u as=0p ps=0u w=640000u l=150000u
X2 a_1108_47# a_193_47# a_761_289# VNB sky130_fd_pr__nfet_01v8 ad=0p pd=0u as=0p ps=0u w=360000u l=150000u
X3 a_1283_21# a_1108_47# a_1462_47# VNB sky130_fd_pr__nfet_01v8 ad=0p pd=0u as=0p ps=0u w=420000u l=150000u
X4 a_651_413# a_27_47# a_543_47# VPB sky130_fd_pr__pfet_01v8_hvt ad=0p pd=0u as=0p ps=0u w=420000u l=150000u
X5 VNB RESET_B a_805_47# VNB sky130_fd_pr__nfet_01v8 ad=0p pd=0u as=0p ps=0u w=420000u l=150000u
X6 VPB CLK a_27_47# VPB sky130_fd_pr__pfet_01v8_hvt ad=0p pd=0u as=0p ps=0u w=640000u l=150000u
X7 Q_N a_1847_47# VNB VNB sky130_fd_pr__nfet_01v8 ad=0p pd=0u as=0p ps=0u w=650000u l=150000u
X8 a_448_47# D VPB VPB sky130_fd_pr__pfet_01v8_hvt ad=0p pd=0u as=0p ps=0u w=420000u l=150000u
X9 VNB a_1283_21# a_1847_47# VNB sky130_fd_pr__nfet_01v8 ad=0p pd=0u as=0p ps=0u w=420000u l=150000u
X10 a_761_289# a_543_47# VNB VNB sky130_fd_pr__nfet_01v8 ad=0p pd=0u as=0p ps=0u w=640000u l=150000u
X11 Q a_1283_21# VNB VNB sky130_fd_pr__nfet_01v8 ad=0p pd=0u as=0p ps=0u w=650000u l=150000u
X12 a_193_47# a_27_47# VNB VNB sky130_fd_pr__nfet_01v8 ad=0p pd=0u as=0p ps=0u w=420000u l=150000u
X13 a_1108_47# a_27_47# a_761_289# VPB sky130_fd_pr__pfet_01v8_hvt ad=0p pd=0u as=0p ps=0u w=420000u l=150000u
X14 a_543_47# a_27_47# a_448_47# VNB sky130_fd_pr__nfet_01v8 ad=0p pd=0u as=0p ps=0u w=360000u l=150000u
X15 a_1462_47# RESET_B VNB VNB sky130_fd_pr__nfet_01v8 ad=0p pd=0u as=0p ps=0u w=420000u l=150000u
X16 a_543_47# a_193_47# a_448_47# VPB sky130_fd_pr__pfet_01v8_hvt ad=0p pd=0u as=0p ps=0u w=420000u l=150000u
X17 a_448_47# D VNB VNB sky130_fd_pr__nfet_01v8 ad=0p pd=0u as=0p ps=0u w=420000u l=150000u
X18 VPB a_1283_21# a_1270_413# VPB sky130_fd_pr__pfet_01v8_hvt ad=0p pd=0u as=0p ps=0u w=420000u l=150000u
X19 VPB a_1108_47# a_1283_21# VPB sky130_fd_pr__pfet_01v8_hvt ad=0p pd=0u as=0p ps=0u w=420000u l=150000u
X20 a_193_47# a_27_47# VPB VPB sky130_fd_pr__pfet_01v8_hvt ad=0p pd=0u as=0p ps=0u w=640000u l=150000u
X21 a_1270_413# a_193_47# a_1108_47# VPB sky130_fd_pr__pfet_01v8_hvt ad=0p pd=0u as=0p ps=0u w=420000u l=150000u
X22 a_1283_21# RESET_B VPB VPB sky130_fd_pr__pfet_01v8_hvt ad=0p pd=0u as=0p ps=0u w=420000u l=150000u
X23 VPB a_761_289# a_651_413# VPB sky130_fd_pr__pfet_01v8_hvt ad=0p pd=0u as=0p ps=0u w=420000u l=150000u
X24 a_639_47# a_193_47# a_543_47# VNB sky130_fd_pr__nfet_01v8 ad=0p pd=0u as=0p ps=0u w=360000u l=150000u
X25 VNB a_1283_21# a_1217_47# VNB sky130_fd_pr__nfet_01v8 ad=0p pd=0u as=0p ps=0u w=420000u l=150000u
X26 Q_N a_1847_47# VPB VPB sky130_fd_pr__pfet_01v8_hvt ad=0p pd=0u as=0p ps=0u w=1e+06u l=150000u
X27 VNB CLK a_27_47# VNB sky130_fd_pr__nfet_01v8 ad=0p pd=0u as=0p ps=0u w=420000u l=150000u
X28 a_761_289# a_543_47# VPB VPB sky130_fd_pr__pfet_01v8_hvt ad=0p pd=0u as=0p ps=0u w=840000u l=150000u
X29 a_651_413# RESET_B VPB VPB sky130_fd_pr__pfet_01v8_hvt ad=0p pd=0u as=0p ps=0u w=420000u l=150000u
X30 Q a_1283_21# VPB VPB sky130_fd_pr__pfet_01v8_hvt ad=0p pd=0u as=0p ps=0u w=1e+06u l=150000u
X31 a_1217_47# a_27_47# a_1108_47# VNB sky130_fd_pr__nfet_01v8 ad=0p pd=0u as=0p ps=0u w=360000u l=150000u
.ends


C0 Vreset sky130_fd_sc_hd__dfrbp_1_0[8]/Q 0.11fF
C1 Vreset sky130_fd_sc_hd__dfrbp_1_0[16]/D 1.55fF
C2 sky130_fd_sc_hd__dfrbp_1_0[6]/Q sky130_fd_sc_hd__dfrbp_1_0[6]/D 0.12fF
C3 Vreset sky130_fd_sc_hd__dfrbp_1_0[0]/Q 0.11fF
C4 sky130_fd_sc_hd__dfrbp_1_0[13]/Q sky130_fd_sc_hd__dfrbp_1_0[13]/D 0.12fF
C5 Vreset sky130_fd_sc_hd__dfrbp_1_0[4]/D 1.45fF
C6 Vreset sky130_fd_sc_hd__dfrbp_1_0[11]/D 1.68fF
C7 sky130_fd_sc_hd__dfrbp_1_0[8]/D sky130_fd_sc_hd__dfrbp_1_0[9]/D 0.08fF
C8 sky130_fd_sc_hd__dfrbp_1_0[7]/Q sky130_fd_sc_hd__dfrbp_1_0[7]/D 0.12fF
C9 Vreset sky130_fd_sc_hd__dfrbp_1_0[15]/Q 0.11fF
C10 sky130_fd_sc_hd__dfrbp_1_0[14]/D sky130_fd_sc_hd__dfrbp_1_0[15]/D 0.08fF
C11 sky130_fd_sc_hd__dfrbp_1_0[1]/D Vreset 1.15fF
C12 sky130_fd_sc_hd__dfrbp_1_0[1]/Q sky130_fd_sc_hd__dfrbp_1_0[1]/D 0.12fF
C13 sky130_fd_sc_hd__dfrbp_1_0[1]/Q Vreset 0.11fF
C14 sky130_fd_sc_hd__dfrbp_1_0[2]/Q sky130_fd_sc_hd__dfrbp_1_0[2]/D 0.12fF
C15 Vreset sky130_fd_sc_hd__dfrbp_1_0[3]/Q 0.11fF
C16 Vreset sky130_fd_sc_hd__dfrbp_1_0[10]/Q 0.11fF
C17 sky130_fd_sc_hd__dfrbp_1_0[8]/Q sky130_fd_sc_hd__dfrbp_1_0[8]/D 0.12fF
C18 Vreset sky130_fd_sc_hd__dfrbp_1_0[18]/D 1.55fF
C19 sky130_fd_sc_hd__dfrbp_1_0[14]/Q sky130_fd_sc_hd__dfrbp_1_0[14]/D 0.12fF
C20 sky130_fd_sc_hd__dfrbp_1_0[2]/D sky130_fd_sc_hd__dfrbp_1_0[3]/D 0.08fF
C21 Vreset sky130_fd_sc_hd__dfrbp_1_0[6]/D 1.55fF
C22 sky130_fd_sc_hd__dfrbp_1_0[0]/Q sky130_fd_sc_hd__dfrbp_1_0[0]/D 0.12fF
C23 Vreset sky130_fd_sc_hd__dfrbp_1_0[13]/D 1.51fF
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
R652 GND.n869 GND.n868 35.847
R653 GND.n790 GND.n789 35.847
R654 GND.n711 GND.n710 35.847
R655 GND.n21 GND.n20 28.613
R656 GND.n16 GND.t130 25.428
R657 GND.n93 GND.t67 25.428
R658 GND.n172 GND.t89 25.428
R659 GND.n251 GND.t70 25.428
R660 GND.n330 GND.t106 25.428
R661 GND.n409 GND.t31 25.428
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
