anuic3/Poly-Silicon-Resistor-Based-Temperature-Sensor-324/Schematics/Counter/poseEdge_Dff.spice

.subckt sky130_fd_sc_hd__dfrbp_1 CLK D RESET_B VGND VPWR Q Q_N
X0 a_1270_413# a_1283_21# VPWR VPWR sky130_fd_pr__pfet_01v8_hvt w=420000u l=150000u
X1 VPWR a_543_47# a_761_289# VPWR sky130_fd_pr__pfet_01v8_hvt w=840000u l=150000u
X2 VGND a_543_47# a_761_289# VGND sky130_fd_pr__nfet_01v8 w=640000u l=150000u
X3 VPWR a_1847_47# Q_N VPWR sky130_fd_pr__pfet_01v8_hvt w=1e+06u l=150000u
X4 VGND D a_448_47# VGND sky130_fd_pr__nfet_01v8 w=420000u l=150000u
X5 a_1108_47# a_193_47# a_1270_413# VPWR sky130_fd_pr__pfet_01v8_hvt w=420000u l=150000u
X6 a_1217_47# a_1283_21# VGND VGND sky130_fd_pr__nfet_01v8 w=420000u l=150000u
X7 a_448_47# a_27_47# a_543_47# VGND sky130_fd_pr__nfet_01v8 w=360000u l=150000u
X8 a_1847_47# a_1283_21# VGND VGND sky130_fd_pr__nfet_01v8 w=420000u l=150000u
X9 VPWR a_1283_21# Q VPWR sky130_fd_pr__pfet_01v8_hvt w=1e+06u l=150000u
X10 a_448_47# a_193_47# a_543_47# VPWR sky130_fd_pr__pfet_01v8_hvt w=420000u l=150000u
X11 a_543_47# a_193_47# a_639_47# VGND sky130_fd_pr__nfet_01v8 w=360000u l=150000u
X12 a_1108_47# a_27_47# a_1217_47# VGND sky130_fd_pr__nfet_01v8 w=360000u l=150000u
X13 a_1462_47# a_1108_47# a_1283_21# VGND sky130_fd_pr__nfet_01v8 w=420000u l=150000u
X14 VGND a_1283_21# Q VGND sky130_fd_pr__nfet_01v8 w=650000u l=150000u
X15 a_543_47# a_27_47# a_651_413# VPWR sky130_fd_pr__pfet_01v8_hvt w=420000u l=150000u
X16 a_805_47# RESET_B VGND VGND sky130_fd_pr__nfet_01v8 w=420000u l=150000u
X17 a_761_289# a_193_47# a_1108_47# VGND sky130_fd_pr__nfet_01v8 w=360000u l=150000u
X18 VPWR RESET_B a_651_413# VPWR sky130_fd_pr__pfet_01v8_hvt w=420000u l=150000u
X19 VGND a_27_47# a_193_47# VGND sky130_fd_pr__nfet_01v8 w=420000u l=150000u
X20 a_27_47# CLK VGND VGND sky130_fd_pr__nfet_01v8 w=420000u l=150000u
X21 a_27_47# CLK VPWR VPWR sky130_fd_pr__pfet_01v8_hvt w=640000u l=150000u
X22 VPWR a_27_47# a_193_47# VPWR sky130_fd_pr__pfet_01v8_hvt w=640000u l=150000u
X23 a_1283_21# a_1108_47# VPWR VPWR sky130_fd_pr__pfet_01v8_hvt w=420000u l=150000u
X24 a_1847_47# a_1283_21# VPWR VPWR sky130_fd_pr__pfet_01v8_hvt w=640000u l=150000u
X25 VGND RESET_B a_1462_47# VGND sky130_fd_pr__nfet_01v8 w=420000u l=150000u
X26 VPWR D a_448_47# VPWR sky130_fd_pr__pfet_01v8_hvt w=420000u l=150000u
X27 a_651_413# a_761_289# VPWR VPWR sky130_fd_pr__pfet_01v8_hvt w=420000u l=150000u
X28 a_761_289# a_27_47# a_1108_47# VPWR sky130_fd_pr__pfet_01v8_hvt w=420000u l=150000u
X29 VGND a_1847_47# Q_N VGND sky130_fd_pr__nfet_01v8 w=650000u l=150000u
X30 VPWR RESET_B a_1283_21# VPWR sky130_fd_pr__pfet_01v8_hvt w=420000u l=150000u
X31 a_639_47# a_761_289# a_805_47# VGND sky130_fd_pr__nfet_01v8 w=420000u l=150000u
.ends
