anuic3/Poly-Silicon-Resistor-Based-Temperature-Sensor-324/postlayout simulations/cb and chopper/buff_final_flat.spice

* NGSPICE file created from buff_final_flat.ext - technology: sky130A

X0 outn2.t0 Fvco_By4_QPH outnch1.t1 VDD sky130_fd_pr__pfet_01v8 ad=0p pd=0u as=0p ps=0u w=2e+06u l=150000u
X1 GND GND GND sky130_fd_pr__res_xhigh_po_0p35 l=1.925e+07u
X2 VDD VDD VDD VDD sky130_fd_pr__pfet_01v8_lvt ad=0p pd=0u as=0p ps=0u w=5e+06u l=1e+06u M=4
X3 outnch2.t3 Fvco_By4_QPH_bar outn1.t3 GND sky130_fd_pr__nfet_01v8 ad=0p pd=0u as=0p ps=0u w=1e+06u l=150000u
X4 outp1.t0 Fvco_By4_QPH outpch1.t0 GND sky130_fd_pr__nfet_01v8 ad=0p pd=0u as=0p ps=0u w=1e+06u l=150000u
X5 outnch2.t12 vinnch2.t5 a_2928_8082.t8 GND sky130_fd_pr__nfet_01v8_lvt ad=0p pd=0u as=0p ps=0u w=4e+06u l=1e+06u
X6 GND GND GND sky130_fd_pr__res_xhigh_po_0p35 l=1.925e+07u
X7 outnch1.t3 vinnch1.t5 a_2928_8082.t10 GND sky130_fd_pr__nfet_01v8_lvt ad=0p pd=0u as=0p ps=0u w=4e+06u l=1e+06u
X8 vinp1.t0 Fvco_By4_QPH vinpch2.t0 VDD sky130_fd_pr__pfet_01v8 ad=0p pd=0u as=0p ps=0u w=2e+06u l=150000u
X9 vinnch2.t4 Fvco_By4_QPH_bar vinn2.t2 VDD sky130_fd_pr__pfet_01v8 ad=0p pd=0u as=0p ps=0u w=2e+06u l=150000u
X10 GND GND GND sky130_fd_pr__res_xhigh_po_0p35 l=1.925e+07u
X11 vinpch1.t4 Fvco_By4_QPH_bar vinp2.t3 GND sky130_fd_pr__nfet_01v8 ad=0p pd=0u as=0p ps=0u w=1e+06u l=150000u
X12 outpch1.t5 vinp1.t5 a_n4372_3570.t3 VDD sky130_fd_pr__pfet_01v8_lvt ad=0p pd=0u as=0p ps=0u w=5e+06u l=1e+06u
X13 GND GND GND sky130_fd_pr__res_xhigh_po_0p35 l=1.925e+07u
X14 VDD a_2014_8080.t0 GND sky130_fd_pr__res_xhigh_po_0p35 l=1.925e+07u
X15 GND GND GND GND sky130_fd_pr__nfet_01v8_lvt ad=0p pd=0u as=0p ps=0u w=1.4e+07u l=1e+06u M=2
X16 a_2928_8082.t7 vinnch2.t6 outnch2.t0 GND sky130_fd_pr__nfet_01v8_lvt ad=0p pd=0u as=0p ps=0u w=4e+06u l=1e+06u
X17 vinp2.t0 Fvco_By4_QPH vinpch2.t1 GND sky130_fd_pr__nfet_01v8 ad=0p pd=0u as=0p ps=0u w=1e+06u l=150000u
X18 vinnch1.t4 Fvco_By4_QPH_bar vinn1.t9 VDD sky130_fd_pr__pfet_01v8 ad=0p pd=0u as=0p ps=0u w=2e+06u l=150000u
X19 outn1.t0 Fvco_By4_QPH outnch2.t1 VDD sky130_fd_pr__pfet_01v8 ad=0p pd=0u as=0p ps=0u w=2e+06u l=150000u
X20 a_n4372_3570.t2 vinp1.t6 outpch1.t4 VDD sky130_fd_pr__pfet_01v8_lvt ad=0p pd=0u as=0p ps=0u w=5e+06u l=1e+06u
X21 GND GND GND sky130_fd_pr__res_xhigh_po_0p35 l=1.925e+07u
X22 a_n2268_8398.t0 a_2014_8716.t0 GND sky130_fd_pr__res_xhigh_po_0p35 l=1.925e+07u
X23 outnch2.t11 vinnch2.t7 a_2928_8082.t6 GND sky130_fd_pr__nfet_01v8_lvt ad=0p pd=0u as=0p ps=0u w=4e+06u l=1e+06u
X24 GND GND GND GND sky130_fd_pr__nfet_01v8_lvt ad=0p pd=0u as=0p ps=0u w=1e+06u l=1e+06u M=2
X25 vinn2.t0 Fvco_By4_QPH vinnch2.t0 GND sky130_fd_pr__nfet_01v8 ad=0p pd=0u as=0p ps=0u w=1e+06u l=150000u
X26 a_2928_8082.t5 vinnch2.t8 outnch2.t10 GND sky130_fd_pr__nfet_01v8_lvt ad=0p pd=0u as=0p ps=0u w=4e+06u l=1e+06u
X27 vinn2.t1 Fvco_By4_QPH vinnch1.t0 VDD sky130_fd_pr__pfet_01v8 ad=0p pd=0u as=0p ps=0u w=2e+06u l=150000u
X28 GND GND GND sky130_fd_pr__res_xhigh_po_0p35 l=1.925e+07u
X29 outpch2.t6 vbiasot GND GND sky130_fd_pr__nfet_01v8_lvt ad=0p pd=0u as=0p ps=0u w=1e+06u l=4e+06u
X30 outpch2.t3 vinp2.t5 a_n4372_3570.t0 VDD sky130_fd_pr__pfet_01v8_lvt ad=0p pd=0u as=0p ps=0u w=5e+06u l=1e+06u
X31 a_2928_8082.t14 vinnch1.t6 outnch1.t9 GND sky130_fd_pr__nfet_01v8_lvt ad=0p pd=0u as=0p ps=0u w=4e+06u l=1e+06u
X32 a_2928_8082.t16 a_7210_8082.t2 GND sky130_fd_pr__res_xhigh_po_0p35 l=1.925e+07u
X33 outnch1.t7 vinnch1.t7 a_2928_8082.t12 GND sky130_fd_pr__nfet_01v8_lvt ad=0p pd=0u as=0p ps=0u w=4e+06u l=1e+06u
X34 a_n4372_3570.t1 vinp2.t6 outpch2.t2 VDD sky130_fd_pr__pfet_01v8_lvt ad=0p pd=0u as=0p ps=0u w=5e+06u l=1e+06u
X35 GND GND GND sky130_fd_pr__res_xhigh_po_0p35 l=1.925e+07u
X36 GND a_7210_8082.t1 GND sky130_fd_pr__res_xhigh_po_0p35 l=1.925e+07u
X37 outnch1.t11 vbiasob a_2014_8716.t1 VDD sky130_fd_pr__pfet_01v8_lvt ad=0p pd=0u as=0p ps=0u w=5e+06u l=2e+06u
X38 outnch1.t5 Fvco_By4_QPH_bar outn1.t2 VDD sky130_fd_pr__pfet_01v8 ad=0p pd=0u as=0p ps=0u w=2e+06u l=150000u
X39 GND GND GND sky130_fd_pr__res_xhigh_po_0p35 l=1.925e+07u
X40 GND GND GND sky130_fd_pr__res_xhigh_po_0p35 l=1.925e+07u
X41 vinn1.t1 Fvco_By4_QPH vinnch1.t1 GND sky130_fd_pr__nfet_01v8 ad=0p pd=0u as=0p ps=0u w=1e+06u l=150000u
X42 VDD a_2014_7126.t1 GND sky130_fd_pr__res_xhigh_po_0p35 l=1.925e+07u
X43 GND GND GND sky130_fd_pr__res_xhigh_po_0p35 l=1.925e+07u
X44 a_2702_3276.t1 VDD GND sky130_fd_pr__res_xhigh_po_0p35 l=1.925e+07u
X45 outnch2.t9 vinnch2.t9 a_2928_8082.t4 GND sky130_fd_pr__nfet_01v8_lvt ad=0p pd=0u as=0p ps=0u w=4e+06u l=1e+06u
X46 GND GND GND sky130_fd_pr__res_xhigh_po_0p35 l=1.925e+07u
X47 outnch1.t13 vinnch1.t8 a_2928_8082.t18 GND sky130_fd_pr__nfet_01v8_lvt ad=0p pd=0u as=0p ps=0u w=4e+06u l=1e+06u
X48 outnch2.t8 vinnch2.t10 a_2928_8082.t3 GND sky130_fd_pr__nfet_01v8_lvt ad=0p pd=0u as=0p ps=0u w=4e+06u l=1e+06u
X49 outp2.t1 Fvco_By4_QPH outpch2.t1 GND sky130_fd_pr__nfet_01v8 ad=0p pd=0u as=0p ps=0u w=1e+06u l=150000u
X50 outp1.t1 Fvco_By4_QPH outpch2.t0 VDD sky130_fd_pr__pfet_01v8 ad=0p pd=0u as=0p ps=0u w=2e+06u l=150000u
X51 GND GND GND sky130_fd_pr__res_xhigh_po_0p35 l=1.925e+07u
X52 a_2928_8082.t2 vinnch2.t11 outnch2.t7 GND sky130_fd_pr__nfet_01v8_lvt ad=0p pd=0u as=0p ps=0u w=4e+06u l=1e+06u
X53 a_2928_8082.t13 vinnch1.t9 outnch1.t8 GND sky130_fd_pr__nfet_01v8_lvt ad=0p pd=0u as=0p ps=0u w=4e+06u l=1e+06u
X54 outnch1.t4 Fvco_By4_QPH_bar outn2.t2 GND sky130_fd_pr__nfet_01v8 ad=0p pd=0u as=0p ps=0u w=1e+06u l=150000u
X55 GND GND GND sky130_fd_pr__res_xhigh_po_0p35 l=1.925e+07u
X56 a_2928_7446.t1 a_7148_3156.t0 GND sky130_fd_pr__res_xhigh_po_0p35 l=1.925e+07u
X57 Bout.t7 outn2.t4 vinn2.t6 GND sky130_fd_pr__nfet_01v8_lvt ad=0p pd=0u as=0p ps=0u w=2e+06u l=1e+06u
X58 Bout_mirror.t1 outp1.t4 vinpch1.t0 VDD sky130_fd_pr__pfet_01v8_lvt ad=0p pd=0u as=0p ps=0u w=5e+06u l=1e+06u
X59 GND GND GND sky130_fd_pr__res_xhigh_po_0p35 l=1.925e+07u
X60 outnch2.t6 vinnch2.t12 a_2928_8082.t1 GND sky130_fd_pr__nfet_01v8_lvt ad=0p pd=0u as=0p ps=0u w=4e+06u l=1e+06u
X61 vinn2.t5 outn2.t5 Bout.t6 GND sky130_fd_pr__nfet_01v8_lvt ad=0p pd=0u as=0p ps=0u w=2e+06u l=1e+06u
X62 Bout.t5 outn2.t6 vinn2.t7 GND sky130_fd_pr__nfet_01v8_lvt ad=0p pd=0u as=0p ps=0u w=2e+06u l=1e+06u
X63 vinpch1.t1 outp1.t5 Bout_mirror.t0 VDD sky130_fd_pr__pfet_01v8_lvt ad=0p pd=0u as=0p ps=0u w=5e+06u l=1e+06u
X64 a_2928_8082.t17 vinnch1.t10 outnch1.t12 GND sky130_fd_pr__nfet_01v8_lvt ad=0p pd=0u as=0p ps=0u w=4e+06u l=1e+06u
X65 vinn2.t8 outn2.t7 Bout.t4 GND sky130_fd_pr__nfet_01v8_lvt ad=0p pd=0u as=0p ps=0u w=2e+06u l=1e+06u
X66 outnch1.t2 vinnch1.t11 a_2928_8082.t9 GND sky130_fd_pr__nfet_01v8_lvt ad=0p pd=0u as=0p ps=0u w=4e+06u l=1e+06u
X67 Bout.t1 outp2.t4 vinpch2.t5 VDD sky130_fd_pr__pfet_01v8_lvt ad=0p pd=0u as=0p ps=0u w=5e+06u l=1e+06u
X68 vinp2.t1 Fvco_By4_QPH vinpch1.t2 VDD sky130_fd_pr__pfet_01v8 ad=0p pd=0u as=0p ps=0u w=2e+06u l=150000u
X69 Bout.t3 outn2.t8 vinn2.t4 GND sky130_fd_pr__nfet_01v8_lvt ad=0p pd=0u as=0p ps=0u w=2e+06u l=1e+06u
X70 GND GND GND sky130_fd_pr__res_xhigh_po_0p35 l=1.925e+07u
X71 outp2.t0 Fvco_By4_QPH outpch1.t1 VDD sky130_fd_pr__pfet_01v8 ad=0p pd=0u as=0p ps=0u w=2e+06u l=150000u
X72 Bout.t2 outn2.t9 vinn2.t9 GND sky130_fd_pr__nfet_01v8_lvt ad=0p pd=0u as=0p ps=0u w=2e+06u l=1e+06u
X73 GND GND GND sky130_fd_pr__res_xhigh_po_0p35 l=1.925e+07u
X74 VDD a_2014_7126.t0 GND sky130_fd_pr__res_xhigh_po_0p35 l=1.925e+07u
X75 outnch2.t5 vbiasob a_7148_3156.t1 VDD sky130_fd_pr__pfet_01v8_lvt ad=0p pd=0u as=0p ps=0u w=5e+06u l=2e+06u
X76 vinpch1.t5 Fvco_By4_QPH_bar vinp1.t3 VDD sky130_fd_pr__pfet_01v8 ad=0p pd=0u as=0p ps=0u w=2e+06u l=150000u
X77 vinnch1.t2 Bout_mirror.t8 a_1459_330.t1 GND sky130_fd_pr__nfet_01v8_lvt ad=0p pd=0u as=0p ps=0u w=1e+06u l=2e+06u
X78 GND GND GND sky130_fd_pr__res_xhigh_po_0p35 l=1.925e+07u
X79 vinpch2.t3 Fvco_By4_QPH_bar vinp1.t2 GND sky130_fd_pr__nfet_01v8 ad=0p pd=0u as=0p ps=0u w=1e+06u l=150000u
X80 outpch2.t5 Fvco_By4_QPH_bar outp2.t3 VDD sky130_fd_pr__pfet_01v8 ad=0p pd=0u as=0p ps=0u w=2e+06u l=150000u
X81 GND GND GND sky130_fd_pr__res_xhigh_po_0p35 l=1.925e+07u
X82 GND GND GND sky130_fd_pr__res_xhigh_po_0p35 l=1.925e+07u
X83 outnch2.t4 Fvco_By4_QPH_bar outn2.t3 VDD sky130_fd_pr__pfet_01v8 ad=0p pd=0u as=0p ps=0u w=2e+06u l=150000u
X84 vinp2.t4 vbiaschopper a_2702_3276.t0 VDD sky130_fd_pr__pfet_01v8_lvt ad=0p pd=0u as=0p ps=0u w=5e+06u l=1e+06u
X85 vinp1.t4 vbiaschopper a_908_3302.t1 VDD sky130_fd_pr__pfet_01v8_lvt ad=0p pd=0u as=0p ps=0u w=5e+06u l=1e+06u
X86 GND GND GND sky130_fd_pr__res_xhigh_po_0p35 l=1.925e+07u
X87 vinnch2.t2 Bout_mirror.t9 a_n2268_6490.t1 GND sky130_fd_pr__nfet_01v8_lvt ad=0p pd=0u as=0p ps=0u w=1e+06u l=2e+06u
X88 a_n2268_8398.t1 a_2014_8080.t1 GND sky130_fd_pr__res_xhigh_po_0p35 l=1.925e+07u
X89 a_2928_7446.t0 a_7210_7128.t1 GND sky130_fd_pr__res_xhigh_po_0p35 l=1.925e+07u
X90 GND GND GND sky130_fd_pr__res_xhigh_po_0p35 l=1.925e+07u
X91 a_n2268_6490.t2 GND GND sky130_fd_pr__res_xhigh_po_0p35 l=1.925e+07u
X92 outnch1.t6 vinnch1.t12 a_2928_8082.t11 GND sky130_fd_pr__nfet_01v8_lvt ad=0p pd=0u as=0p ps=0u w=4e+06u l=1e+06u
X93 vinpch2.t4 outp2.t5 Bout.t0 VDD sky130_fd_pr__pfet_01v8_lvt ad=0p pd=0u as=0p ps=0u w=5e+06u l=1e+06u
X94 GND GND GND sky130_fd_pr__res_xhigh_po_0p35 l=1.925e+07u
X95 outnch2.t13 vinnch2.t13 a_2928_8082.t0 GND sky130_fd_pr__nfet_01v8_lvt ad=0p pd=0u as=0p ps=0u w=4e+06u l=1e+06u
X96 GND GND GND sky130_fd_pr__res_xhigh_po_0p35 l=1.925e+07u
X97 a_n4372_3570.t4 a_2014_7126.t2 GND sky130_fd_pr__res_xhigh_po_0p35 l=1.925e+07u
X98 GND GND GND sky130_fd_pr__res_xhigh_po_0p35 l=1.925e+07u
X99 GND GND GND sky130_fd_pr__res_xhigh_po_0p35 l=1.925e+07u
X100 a_1459_330.t0 GND GND sky130_fd_pr__res_xhigh_po_0p35 l=1.925e+07u
X101 GND GND GND sky130_fd_pr__res_xhigh_po_0p35 l=1.925e+07u
X102 GND a_7210_8082.t0 GND sky130_fd_pr__res_xhigh_po_0p35 l=1.925e+07u
X103 GND GND GND sky130_fd_pr__res_xhigh_po_0p35 l=1.925e+07u
X104 GND GND GND sky130_fd_pr__res_xhigh_po_0p35 l=1.925e+07u
X105 outpch2.t4 Fvco_By4_QPH_bar outp1.t2 GND sky130_fd_pr__nfet_01v8 ad=0p pd=0u as=0p ps=0u w=1e+06u l=150000u
X106 Bout_mirror.t7 outn1.t4 vinn1.t5 GND sky130_fd_pr__nfet_01v8_lvt ad=0p pd=0u as=0p ps=0u w=2e+06u l=1e+06u
X107 VDD a_7210_7128.t0 GND sky130_fd_pr__res_xhigh_po_0p35 l=1.925e+07u
X108 GND GND GND sky130_fd_pr__res_xhigh_po_0p35 l=1.925e+07u
X109 outpch1.t6 vbiasot GND GND sky130_fd_pr__nfet_01v8_lvt ad=0p pd=0u as=0p ps=0u w=1e+06u l=4e+06u
X110 vinn1.t4 outn1.t5 Bout_mirror.t6 GND sky130_fd_pr__nfet_01v8_lvt ad=0p pd=0u as=0p ps=0u w=2e+06u l=1e+06u
X111 Bout_mirror.t5 outn1.t6 vinn1.t2 GND sky130_fd_pr__nfet_01v8_lvt ad=0p pd=0u as=0p ps=0u w=2e+06u l=1e+06u
X112 vinn1.t3 outn1.t7 Bout_mirror.t4 GND sky130_fd_pr__nfet_01v8_lvt ad=0p pd=0u as=0p ps=0u w=2e+06u l=1e+06u
X113 Bout_mirror.t3 outn1.t8 vinn1.t6 GND sky130_fd_pr__nfet_01v8_lvt ad=0p pd=0u as=0p ps=0u w=2e+06u l=1e+06u
X114 GND GND GND sky130_fd_pr__res_xhigh_po_0p35 l=1.925e+07u
X115 VDD a_908_3302.t0 GND sky130_fd_pr__res_xhigh_po_0p35 l=1.925e+07u
X116 Bout_mirror.t2 outn1.t9 vinn1.t7 GND sky130_fd_pr__nfet_01v8_lvt ad=0p pd=0u as=0p ps=0u w=2e+06u l=1e+06u
X117 vinnch1.t3 Fvco_By4_QPH_bar vinn2.t3 GND sky130_fd_pr__nfet_01v8 ad=0p pd=0u as=0p ps=0u w=1e+06u l=150000u
X118 vinp1.t1 Fvco_By4_QPH vinpch1.t3 GND sky130_fd_pr__nfet_01v8 ad=0p pd=0u as=0p ps=0u w=1e+06u l=150000u
X119 vinn1.t0 Fvco_By4_QPH vinnch2.t1 VDD sky130_fd_pr__pfet_01v8 ad=0p pd=0u as=0p ps=0u w=2e+06u l=150000u
X120 outpch1.t3 Fvco_By4_QPH_bar outp1.t3 VDD sky130_fd_pr__pfet_01v8 ad=0p pd=0u as=0p ps=0u w=2e+06u l=150000u
X121 a_n2268_6490.t0 GND GND sky130_fd_pr__res_xhigh_po_0p35 l=1.925e+07u
X122 GND GND GND sky130_fd_pr__res_xhigh_po_0p35 l=1.925e+07u
X123 GND GND GND sky130_fd_pr__res_xhigh_po_0p35 l=1.925e+07u
X124 GND GND GND sky130_fd_pr__res_xhigh_po_0p35 l=1.925e+07u
X125 outpch1.t2 Fvco_By4_QPH_bar outp2.t2 GND sky130_fd_pr__nfet_01v8 ad=0p pd=0u as=0p ps=0u w=1e+06u l=150000u
X126 outnch1.t10 vinnch1.t13 a_2928_8082.t15 GND sky130_fd_pr__nfet_01v8_lvt ad=0p pd=0u as=0p ps=0u w=4e+06u l=1e+06u
X127 GND GND GND sky130_fd_pr__res_xhigh_po_0p35 l=1.925e+07u
X128 outn2.t1 Fvco_By4_QPH outnch2.t2 GND sky130_fd_pr__nfet_01v8 ad=0p pd=0u as=0p ps=0u w=1e+06u l=150000u
X129 outn1.t1 Fvco_By4_QPH outnch1.t0 GND sky130_fd_pr__nfet_01v8 ad=0p pd=0u as=0p ps=0u w=1e+06u l=150000u
X130 vinpch2.t2 Fvco_By4_QPH_bar vinp2.t2 VDD sky130_fd_pr__pfet_01v8 ad=0p pd=0u as=0p ps=0u w=2e+06u l=150000u
X131 a_1459_330.t2 GND GND sky130_fd_pr__res_xhigh_po_0p35 l=1.925e+07u
X132 vinnch2.t3 Fvco_By4_QPH_bar vinn1.t8 GND sky130_fd_pr__nfet_01v8 ad=0p pd=0u as=0p ps=0u w=1e+06u l=150000u
C0 outnch2 outnch1 2.04fF
C78 outn2 outnch1 2.35fF
C2 outn2 Bout 3.22fF
C3 outp2 VDD 2.58fF
C4 vinnch2 vinn2 2.56fF
C5 outnch2 outn1 2.53fF
C6 vinpch2 vinpch1 3.20fF
C7 outn2 outn1 2.95fF
C8 outp2 outpch1 2.25fF
C9 vinnch1 vinn2 2.50fF
C10 outp1 outp2 4.58fF
C11 outp1 VDD 2.55fF
C12 outp2 outpch2 2.44fF
C13 vinpch2 vinp2 4.36fF
C14 Fvco_By4_QPH Fvco_By4_QPH_bar 3.75fF
C15 vinp2 vinpch1 2.43fF
C16 vinpch2 vinp1 2.29fF
C17 outp1 outpch1 2.35fF
C18 outpch1 outpch2 2.88fF
C19 vinp1 vinpch1 3.02fF
C20 outp1 outpch2 2.13fF
C21 Bout_mirror outn1 3.47fF
C22 outnch1 outn1 2.15fF
C23 vinp2 vinp1 2.62fF
C24 vinnch2 vinn1 2.25fF
C25 outnch2 vinnch2 2.40fF
C26 vinnch1 vinnch2 4.40fF
C27 vinnch1 vinn1 4.39fF
C28 outnch2 outn2 2.10fF
R0 outnch1.n0 outnch1.t1 14.331
R1 outnch1.n1 outnch1.n0 0.393
R2 outnch1.n0 outnch1.n11 2.815
R3 outnch1.n11 outnch1.t0 17.453
R4 outnch1.n11 outnch1.t4 17.451
R5 outnch1.n1 outnch1.t5 14.505
R6 outnch1.n2 outnch1.n1 815.608
R7 outnch1 outnch1.n2 182.569
R8 outnch1 outnch1.n8 146.212
R9 outnch1.n9 outnch1.t13 212.622
R10 outnch1.n10 outnch1.n9 208.271
R11 outnch1.n8 outnch1.n10 76.046
R12 outnch1.n10 outnch1.t10 4.351
R13 outnch1.n9 outnch1.t2 4.351
R14 outnch1.n4 outnch1.n5 0.001
R15 outnch1.n6 outnch1.n7 0.001
R16 outnch1.n4 outnch1.n3 208.271
R17 outnch1.n6 outnch1.n4 208.271
R18 outnch1.n8 outnch1.n6 155.811
R19 outnch1.n7 outnch1.t6 4.35
R20 outnch1.n7 outnch1.t12 4.35
R21 outnch1.n5 outnch1.t7 4.35
R22 outnch1.n5 outnch1.t9 4.35
R23 outnch1.n3 outnch1.t3 4.35
R24 outnch1.n3 outnch1.t8 4.35
R25 outnch1.n2 outnch1.t11 5.714
R26 outn2.n0 outn2.t0 14.331
R27 outn2 outn2.n0 9.029
R28 outn2 outn2.n6 52.138
R29 outn2.n7 outn2.t6 48.21
R30 outn2.n7 outn2.t4 127.084
R31 outn2.n6 outn2.n7 1.418
R32 outn2.n6 outn2.n4 31.793
R33 outn2.n5 outn2.t7 48.21
R34 outn2.n5 outn2.t5 127.084
R35 outn2.n4 outn2.n5 1.418
R36 outn2.n3 outn2.t9 48.21
R37 outn2.n3 outn2.t8 127.084
R38 outn2.n4 outn2.n3 35.06
R39 outn2.n1 outn2.n2 4.438
R40 outn2.n0 outn2.n1 3.405
R41 outn2.n2 outn2.t1 17.451
R42 outn2.n2 outn2.t2 17.452
R43 outn2.n1 outn2.t3 14.302
R44 outn1.t0 outn1.n5 15.994
R45 outn1.n6 outn1.n7 1.885
R46 outn1.n5 outn1.n6 3.212
R47 outn1.n7 outn1.t3 18.036
R48 outn1.n7 outn1.t1 17.538
R49 outn1.n6 outn1.t2 14.302
R50 outn1 outn1.n5 5.994
R51 outn1 outn1.n3 419.301
R52 outn1.n4 outn1.t6 48.21
R53 outn1.n4 outn1.t4 127.084
R54 outn1.n3 outn1.n4 1.418
R55 outn1.n3 outn1.n1 31.793
R56 outn1.n2 outn1.t7 48.21
R57 outn1.n2 outn1.t5 127.084
R58 outn1.n1 outn1.n2 1.418
R59 outn1.n0 outn1.t9 48.21
R60 outn1.n0 outn1.t8 127.084
R61 outn1.n1 outn1.n0 35.06
R62 outnch2.n0 outnch2.t1 14.302
R63 outnch2.n10 outnch2.n0 0.497
R64 outnch2.n11 outnch2.t3 17.453
R65 outnch2.n10 outnch2.n11 1.13
R66 outnch2.n11 outnch2.t2 17.451
R67 outnch2.n1 outnch2.n10 886.086
R68 outnch2 outnch2.n1 177.269
R69 outnch2 outnch2.n9 268.96
R70 outnch2.n7 outnch2.t9 212.622
R71 outnch2.n8 outnch2.n7 208.271
R72 outnch2.n9 outnch2.n8 73.665
R73 outnch2.n8 outnch2.t13 4.351
R74 outnch2.n7 outnch2.t8 4.351
R75 outnch2.n3 outnch2.n4 0.001
R76 outnch2.n5 outnch2.n6 0.001
R77 outnch2.n3 outnch2.n2 208.271
R78 outnch2.n5 outnch2.n3 208.271
R79 outnch2.n9 outnch2.n5 164.114
R80 outnch2.n6 outnch2.t6 4.35
R81 outnch2.n6 outnch2.t10 4.35
R82 outnch2.n4 outnch2.t11 4.35
R83 outnch2.n4 outnch2.t0 4.35
R84 outnch2.n2 outnch2.t12 4.35
R85 outnch2.n2 outnch2.t7 4.35
R86 outnch2.n1 outnch2.t5 5.714
R87 outnch2.n0 outnch2.t4 14.473
R88 outpch1.n0 outpch1.t1 14.302
R89 outpch1.n4 outpch1.t0 18.036
R90 outpch1.n0 outpch1.n4 1.885
R91 outpch1.n4 outpch1.t2 17.538
R92 outpch1.n3 outpch1.n0 1.609
R93 outpch1.n2 outpch1.n3 43.347
R94 outpch1.n2 outpch1.n1 891.943
R95 outpch1.n1 outpch1.t5 5.713
R96 outpch1.n1 outpch1.t4 5.713
R97 outpch1 outpch1.n2 219.544
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
R293 outpch2.n0 outpch2.t0 14.302
R294 outpch2.n0 outpch2.n4 4.438
R295 outpch2.n4 outpch2.t4 17.451
R296 outpch2.n4 outpch2.t1 17.452
R297 outpch2.n1 outpch2.n0 3.405
R298 outpch2.n3 outpch2.n1 34.013
R299 outpch2.n3 outpch2.n2 703.99
R300 outpch2.n2 outpch2.t3 5.713
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
